velezf/lora-rocket-telemetry/RocketLoRaTelemetry/Feather9x_RX/README.md

# Feather9x RX — Ground Station Firmware

Receiver firmware for the Adafruit Feather M0 + RFM95 LoRa ground station.
Parses incoming telemetry packets, pretty-prints to USB serial, and
sends ACK replies to the rocket.

See the [parent README](../README.md) for full system documentation.
