velezf/lora-rocket-telemetry/docs/site/images/card-lora-radiorocket-v2.jpg

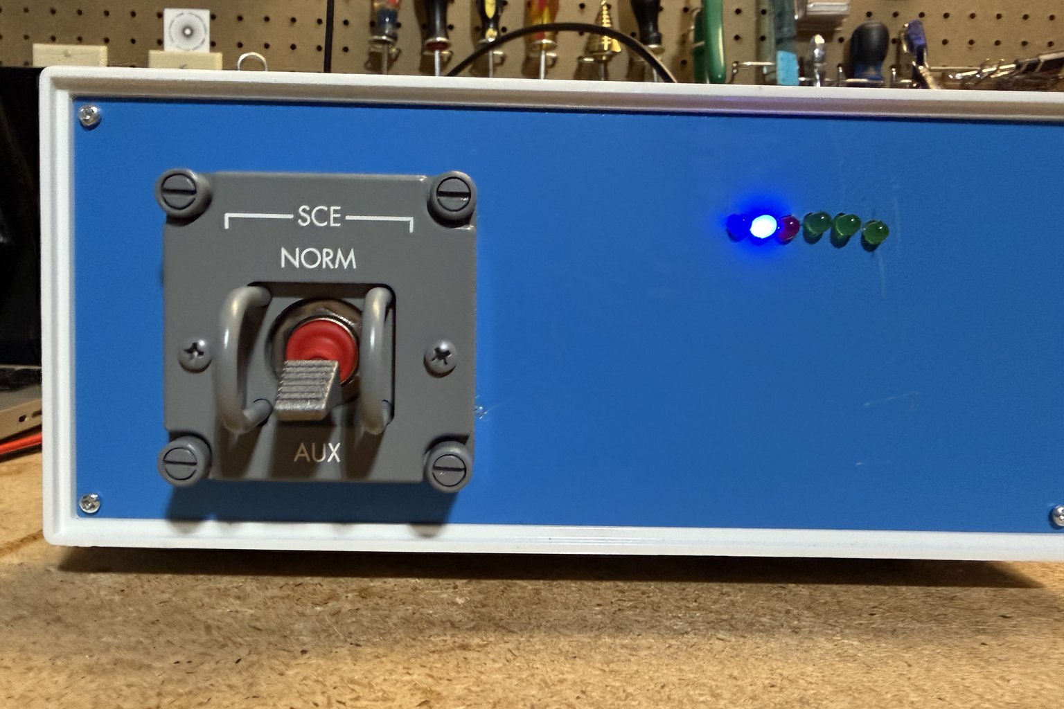
docs/site/images/card-lora-radiorocket-v2.jpg
