velezf/lora-rocket-telemetry/docs/site/images/v2-gs-interior-2.jpg

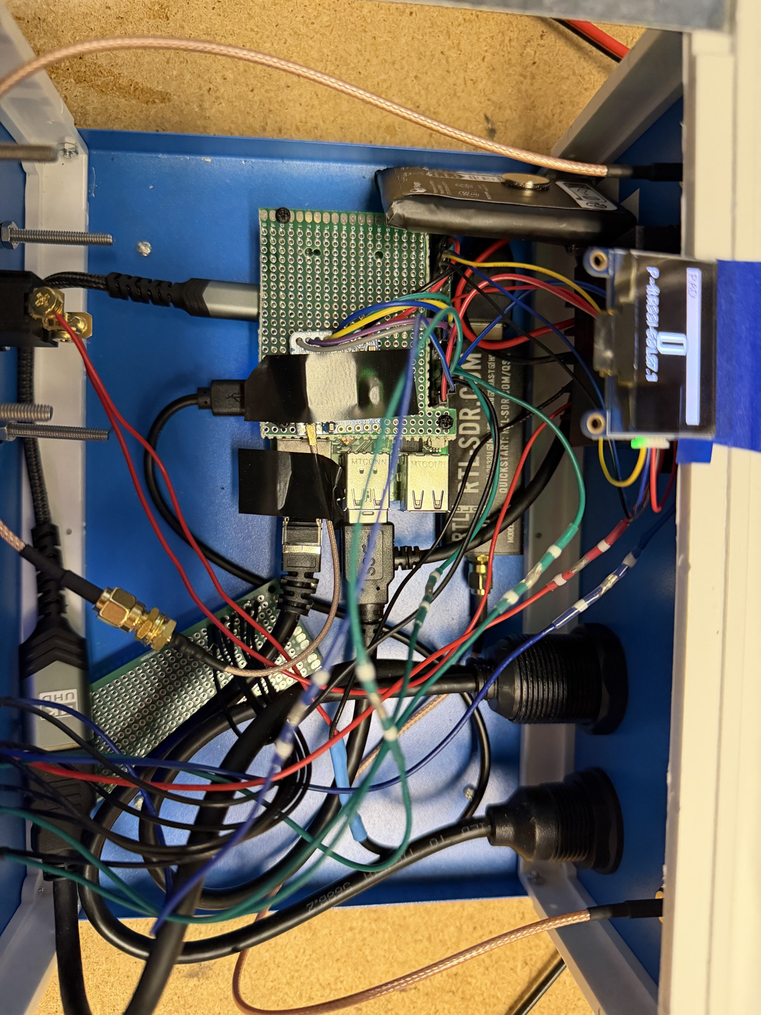
docs/site/images/v2-gs-interior-2.jpg
