velezf/lora-rocket-telemetry/RocketLoRaTelemetry/Feather9x_RX/Rx_BaseStation/Basestation1.jpeg

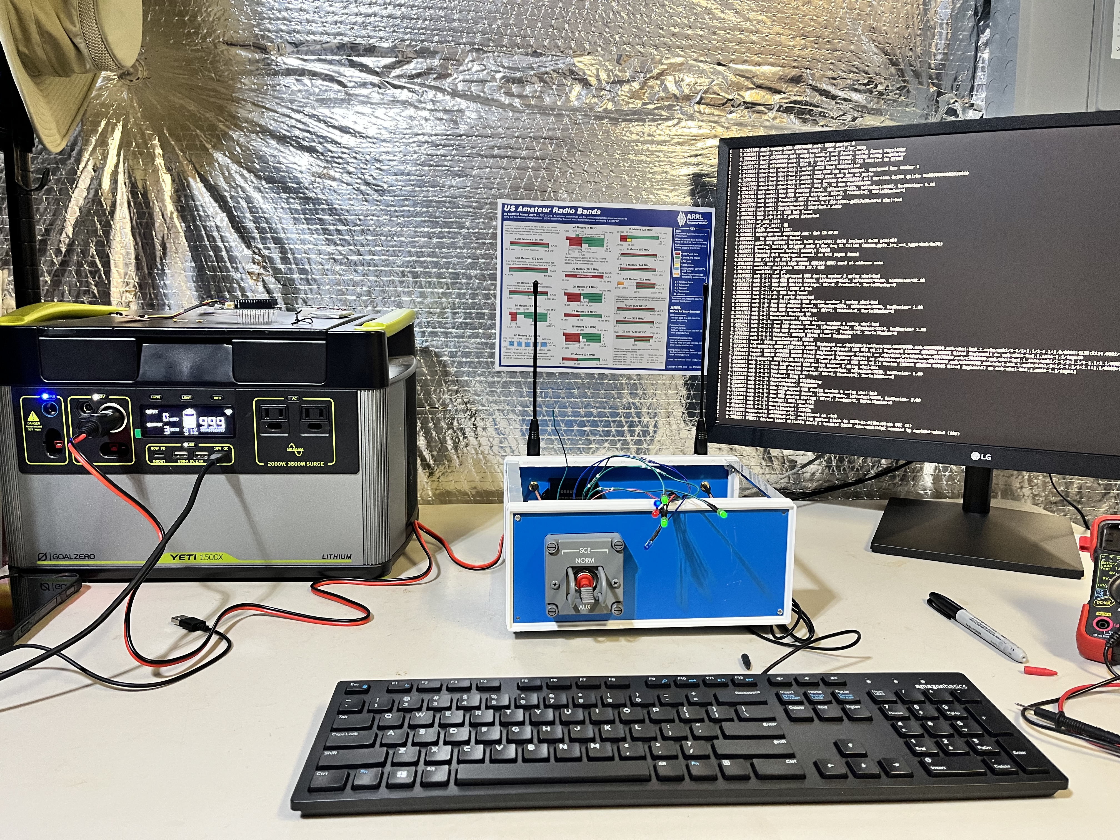
RocketLoRaTelemetry/Feather9x_RX/Rx_BaseStation/Basestation1.jpeg
