velezf/lora-rocket-telemetry/RocketLoRaTelemetry/Feather9x_RX/Rx_BaseStation/Basestationfront.jpeg

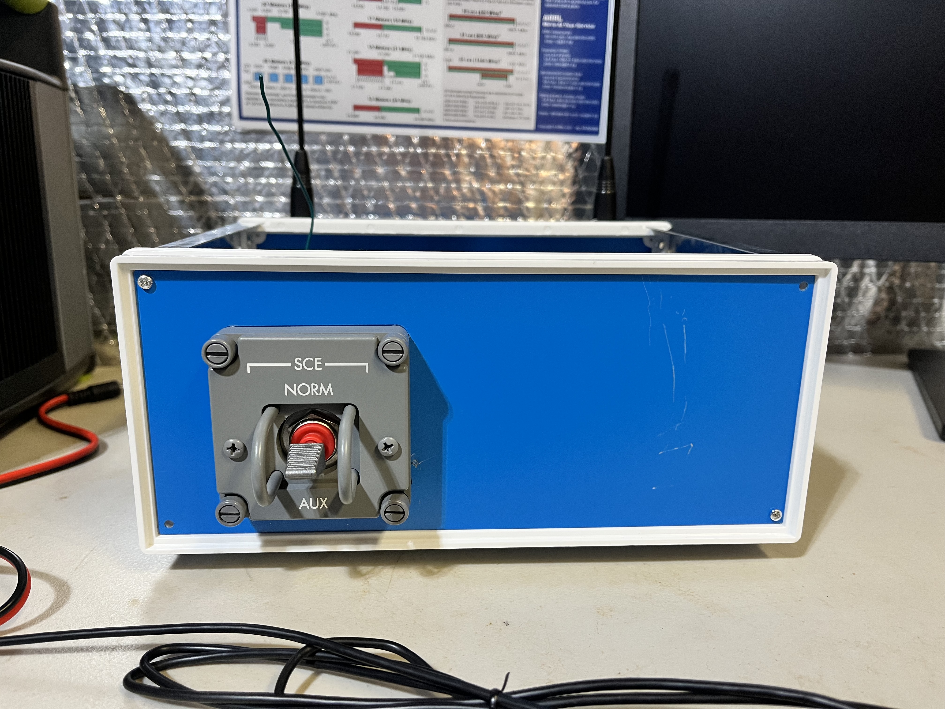
RocketLoRaTelemetry/Feather9x_RX/Rx_BaseStation/Basestationfront.jpeg
