velezf/lora-rocket-telemetry/RocketLoRaTelemetry/Feather9x_RX/Rx_BaseStation/RangeSetup.jpeg

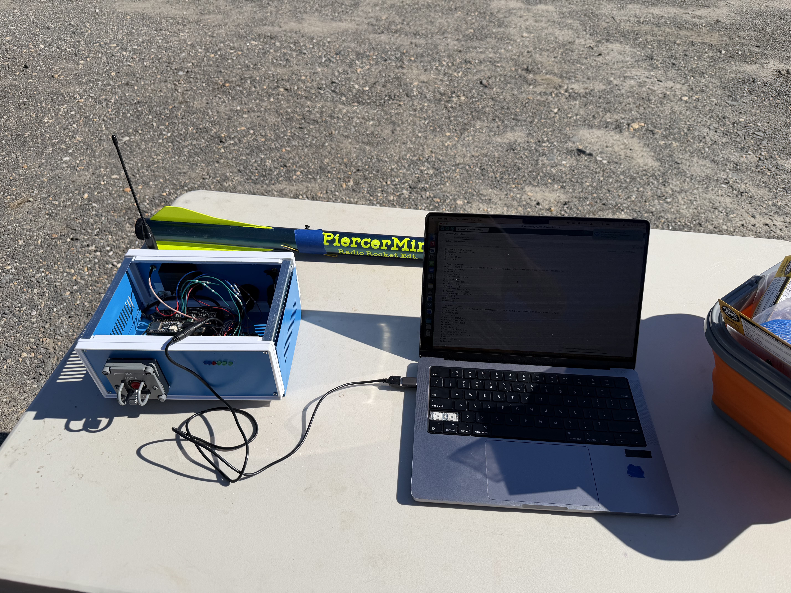
RocketLoRaTelemetry/Feather9x_RX/Rx_BaseStation/RangeSetup.jpeg
