velezf/lora-rocket-telemetry/handheld/app/game.py

"""Guess-the-apogee (Epic 8.4) — pure game logic, time injected.

KID-TWEAKABLE KNOBS (Epic 8.5 — change these, restart the service):
    PLAYERS      who gets a guess, in dialing order (names show on the OLED —
                 keep them ~7 chars so they fit the 128 px screen)
    RULE         "closest" = smallest |guess - actual| wins (over or under);
                 "no-over" = Price-Is-Right: closest WITHOUT going over —
                 everyone busts, nobody wins (the rocket wins)
    STEP_FT      how many feet one button press adds/removes
    START_FT     where the dial starts
    DEBOUNCE_S   ignore button bounces closer together than this

Phases: "rules" (startup: pick the game — dial toggles Closest/NoOver,
lock confirms; the RULE knob is the preselection) -> "entry" (on the pad, dialing) -> "watching" (flight; betting window
closed at liftoff or when every seat is taken) -> "reveal" (apogee: the
actual peak and whose guess came closest — ties go to the earlier kid).
Locking is a TWO-press affair: #12 shows "<name> <guess> OK?" and only a
second #12 banks it — dialing during the OK? cancels back to adjusting.
(Field feedback 2026-08-31: one-press lock was guaranteed kid-fumble.)
A dialed-but-never-locked guess banks automatically at liftoff: a kid who
dialed 350 and got distracted by the countdown still played.
"""
from __future__ import annotations

from handheld.app.rockets import MOTORS, ROCKETS
from handheld.app.rocketsim import apogee_ft

PLAYERS = ("Bacon", "HnyBsct", "Dragon")
RULE = "closest"
STEP_FT = 25
START_FT = 300
DEBOUNCE_S = 0.15


class GuessGame:
    def __init__(self, step_ft: int = STEP_FT, start_ft: int = START_FT,
                 players: tuple[str, ...] = PLAYERS, rule: str = RULE,
                 debounce_s: float = DEBOUNCE_S):
        assert rule in ("closest", "no-over"), rule
        self.rule = rule
        self._step = step_ft
        self.players = tuple(players)
        self._debounce_s = debounce_s
        self._last_press: float | None = None

        # rules | rocket | motor | entry | watching | reveal
        self.phase = "rules"
        self.mode = "live"                   # live (radio) | lab (offline sim)
        self._menu_i = 0 if rule == "closest" else 1
        self._rocket_i = 0
        self._motor_i = 0
        self.current_guess = start_ft
        self.guesses: list[int] = []         # locked, in PLAYERS order
        self.winner: tuple[str, int] | None = None   # (player name, guess)
        self.peak_ft: int | None = None
        self.confirming = False
        self._dial_touched = False
        self._seen_flight = False
        self._stashed: list[int] | None = None   # real-flight guesses parked
                                                 # during an armed side quest

    @property
    def entering_name(self) -> str:
        return self.players[len(self.guesses)]

    _MENU = (("closest", "Closest"), ("no-over", "NoOver"), ("lab", "RocketLab"))

    @property
    def menu_label(self) -> str:
        return self._MENU[self._menu_i][1]

    @property
    def rocket_row(self):
        return ROCKETS[self._rocket_i]

    @property
    def motor_row(self):
        return MOTORS[self._motor_i]

    @property
    def armed(self) -> bool:
        """All guesses banked, rocket still on the pad — awaiting launch."""
        return self.phase == "watching" and not self._seen_flight

    def reset(self) -> None:
        """Start over (the #5+#6 chord, or the sled's next-flight St cycle).

        From a side quest (real guesses stashed) the chord means "leave the
        quiz", so it RESTORES the armed game rather than wiping the kids'
        real-flight guesses; a second chord from plain armed is the full
        start-over as always."""
        stash = self._stashed
        self.__init__(step_ft=self._step, players=self.players,
                      rule=self.rule, debounce_s=self._debounce_s)
        if stash is not None:
            self.guesses = list(stash)
            self.phase = "watching"          # armed again, awaiting launch

    # -- buttons ------------------------------------------------------------
    def _debounced(self, mono: float) -> bool:
        if self._last_press is not None and mono - self._last_press < self._debounce_s:
            return True
        self._last_press = mono
        return False

    def _dial_menu(self, step: int) -> None:
        if self.phase == "rules":
            self._menu_i = (self._menu_i + step) % len(self._MENU)
            key = self._MENU[self._menu_i][0]
            if key != "lab":
                self.rule = key              # live picks double as the rule
        elif self.phase == "rocket":
            self._rocket_i = (self._rocket_i + step) % len(ROCKETS)
        elif self.phase == "motor":
            self._motor_i = (self._motor_i + step) % len(MOTORS)

    def press_up(self, mono: float) -> None:
        if self.phase not in ("rules", "rocket", "motor", "entry") or self._debounced(mono):
            return
        if self.phase != "entry":
            self._dial_menu(+1)
            return
        self.confirming = False              # dialing cancels the OK?
        self.current_guess += self._step
        self._dial_touched = True

    def press_down(self, mono: float) -> None:
        if self.phase not in ("rules", "rocket", "motor", "entry") or self._debounced(mono):
            return
        if self.phase != "entry":
            self._dial_menu(-1)
            return
        self.confirming = False              # dialing cancels the OK?
        self.current_guess = max(0, self.current_guess - self._step)
        self._dial_touched = True

    def press_lock(self, mono: float) -> None:
        if (self.phase not in ("rules", "rocket", "motor", "entry",
                               "watching", "reveal")
                or self._debounced(mono)):
            return
        if self.phase == "watching":
            if self.armed and self.mode == "live":
                # side quest: play RocketLab while awaiting launch — the
                # real-flight guesses are STASHED, never lost
                self._stashed = list(self.guesses)
                self.guesses = []
                self.confirming = False
                self.mode = "lab"
                self.phase = "rocket"
            return
        if self.phase == "reveal":
            if self.mode == "lab":           # another round while waiting
                self.guesses = []
                self.winner = None
                self.peak_ft = None
                self.confirming = False
                self.phase = "rocket"
            return
        if self.phase == "rules":            # game confirmed
            if self._MENU[self._menu_i][0] == "lab":
                self.mode = "lab"
                self.phase = "rocket"
            else:
                self.phase = "entry"
            return
        if self.phase == "rocket":
            self.phase = "motor"
            return
        if self.phase == "motor":
            self.phase = "entry"
            return
        if not self.confirming:              # first press only ASKS
            self.confirming = True
            return
        self.confirming = False              # second press BANKS
        self.guesses.append(self.current_guess)
        self._dial_touched = False
        if len(self.guesses) >= len(self.players):
            if self.mode == "lab":
                self._lab_reveal()           # the sim answers NOW: no launch
            else:
                self.phase = "watching"

    def _lab_reveal(self) -> None:
        peak = apogee_ft(self.rocket_row, self.motor_row)
        self.peak_ft = peak
        if self.guesses:
            i = min(range(len(self.guesses)),
                    key=lambda i: abs(self.guesses[i] - peak))
            self.winner = (self.players[i], self.guesses[i])
        self.phase = "reveal"

    # -- flight-driven transitions ------------------------------------------
    def on_view(self, view) -> None:
        if view.st is not None and view.st != 0:
            self._seen_flight = True
            if self.mode == "lab":
                # A REAL LIFTOFF PREEMPTS THE QUIZ (decided 2026-08-31):
                # the lab round is discarded, the flight owns the screen —
                # and stashed real-flight guesses come back for the reveal
                self.mode = "live"
                self.phase = "watching"
                self.guesses = (list(self._stashed)
                                if self._stashed is not None else [])
                self._stashed = None
                self.confirming = False
        # St RETURNED to 0 after a flight = next launch: fresh round. The
        # transition matters: plain pad frames must NOT reset a locked-in
        # game awaiting launch (family bench 2026-08-31 — it bounced kids
        # back to the menu the moment they finished locking in).
        if (self.phase in ("watching", "reveal") and view.st == 0
                and self._seen_flight):
            self.reset()
            return
        if self.phase == "rules" and view.st is not None and view.st != 0:
            self.phase = "watching"          # it flew mid-menu: no game this round
        if self.phase == "entry" and view.st is not None and view.st != 0:
            if self._dial_touched and len(self.guesses) < len(self.players):
                self.guesses.append(self.current_guess)   # a dialed kid still played
                self._dial_touched = False
            self.confirming = False
            self.phase = "watching"
        if (self.phase in ("entry", "watching") and view.apogee_reveal
                and view.peak_ft is not None):
            self.peak_ft = view.peak_ft
            peak = view.peak_ft
            eligible = range(len(self.guesses))
            if self.rule == "no-over":
                eligible = [i for i in eligible if self.guesses[i] <= peak]
            if self.guesses and eligible:
                # min() is stable: equal distances resolve to the earlier kid
                i = min(eligible, key=lambda i: abs(self.guesses[i] - peak))
                self.winner = (self.players[i], self.guesses[i])
            self.phase = "reveal"
