velezf/lora-rocket-telemetry/(commit log)

2026-05-09 cleanup: remove vendored libraries (all available via Arduino Library Manager)
2026-05-09 Add files via upload
    photos: add RX ground station build photos
2026-05-09 cleanup: remove N3VEM ground station photos zip
2026-05-09 docs: rewrite GroundStation README for LePotato APRS digipeater build
    Condensed the readme to focus on key project details and removed outdated sections.
2026-05-09 Correct 'mid-power' to 'High-power' in readme
2026-05-09 docs: update root README with real-time framing, NAR L1, and Zephyr high-power status
    Updated project description and telemetry details for clarity.
2026-06-29 feat(firmware): scaffold PlatformIO dev environment for sled
    Greenfield firmware/ PlatformIO project for the Feather M0 sled (the
    only C++ node). Two build environments:
    - feather_m0_tx: atmelsam / adafruit_feather_m0 / arduino, pinned
    lib_deps: RadioHead 1.120.0, Adafruit BMP3XX 2.1.6, ADXL375 1.1.2,
    Unified Sensor 1.1.15
    - native: dependency-free host env for Unity logic tests
    lib/README records the purity rule (no Arduino.h / no RadioHead in lib/)
    that keeps logic native-testable. Build artifacts (.pio/, machine-specific
    .vscode files) gitignored. Existing V1 RocketLoRaTelemetry/ firmware
    untouched (reference only).
    Epic 1, tasks 1.1 and 1.2.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
2026-06-29 test(firmware): add native test harness with RED->GREEN smoke test
    Proves the host-side Unity loop runs on macOS with no board attached: a
    deliberately failing assertion was confirmed to fail and propagate a non-zero
    result (RED), then corrected to pass (GREEN).
    test_ignore = * on the feather_m0_tx env guarantees host-logic tests are never
    cross-compiled to the SAMD target; run the suite with `pio test -e native`.
    A bare `pio test` is a safe no-op since default_envs is pinned to the board
    for build/upload.
    Temporary canary — superseded by the first real logic unit when the V1 .ino
    logic is ported.
    Epic 1, task 1.3.
2026-06-29 handheld(epic8): platform groundwork — ADR + provisioning runbook + uv env
    Capture the Pi Zero 2 W "kids' mission-control handheld" (Epic 8) platform
    decision and reproducible bring-up while the Pi was on the bench. Receiver-only
    node on the shared v1 packet contract; reuses the Epic 2.5 native-RX pattern.
    - ADR 0001: Pi Zero 2 W + Adafruit LoRa Radio Bonnet (RFM96W, 434 MHz) + PiSugar 3,
    Python/Blinka via uv, rpi-lgpio shim for kernel-6.x GPIO.
    - README: verified fresh-card provisioning runbook (apt, I2C/SPI, PiSugar,
    uv env, swig/liblgpio-dev build deps) + the Trixie zram-tools gotcha.
    - uv env: pyproject + uv.lock + .python-version mirroring ~/radio on the device.
    Groundwork only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
2026-06-30 docs(adr): packet format v1 — shared telemetry contract
    Locks the v1 wire contract between the sled TX and every receiver:
    space-delimited keyed KEY:VALUE ASCII with a leading V:1 version field.
    Defines the field spec, a golden example packet, and the versioning
    policy (reject unknown versions; additive tags within a version; only
    breaking changes to existing tags bump V). The C encoder (3.2) and the
    Python decoder (4.1) both assert against this ADR's golden vector.
2026-06-30 docs(adr): align handheld ADR packet example with locked v1 contract
    The handheld ADR's inline example predated the lock and showed the legacy
    `t+12s` time token (and St in a different slot). Replace it with the
    authoritative golden vector (MET:12) from docs/adr/0001-packet-format-v1.md
    and link to that ADR as the single source of truth, so the 8.2 parser is
    written against the real contract.
2026-06-30 docs: add CLAUDE.md project memory + docs/RESUME.md status
    CLAUDE.md captures the durable working agreement (branch-per-feature,
    Frank reviews/approves every commit & merge, TDD, commit conventions, the
    lib/ purity rule, pio invocation, hardware gating) and points at the
    keystone packet ADR. docs/RESUME.md is the living status/handoff doc —
    current epic, open branches, locked decisions, next steps — to read first
    when resuming, especially across the Mac/Pi 5 split.
2026-06-30 docs: record Epic 2 ground-station progress; Bookworm -> Trixie
    Ground station apogee-gs is on the network: 2.1 OS baseline (updates, EEPROM
    flashed, headless SSH, I2C+SPI enabled), 2.2 Wi-Fi-on-boot (home WideRoad
    first, iPhone hotspot fallback, cold-boot rejoin verified), and Pi Connect
    (rpi-connect-lite, signed in as apogee-gs). 2.3/2.4 deferred; 2.5/2.6
    hardware-blocked; hotspot fallback not yet field-verified.
    Also corrects the plan's 2.1 OS from Bookworm to Trixie (Debian 13), the
    image actually flashed. Hotspot credentials are NOT stored in the repo.
2026-06-30 docs(resume): Epic 2 software side complete (2.3/2.4 + auth + Python 3)
    Ground station apogee-gs is software-complete: Claude Code installed and
    authenticated (claude.ai Max), GitHub read-only deploy key + clone + pull
    verified, Python 3.13.5 confirmed (venv works; no system pip, uv not yet
    installed). Epic 2 row flips to green — only 2.5 radio / 2.6 PiSugar remain
    (hardware-blocked). Next steps: optional uv install, then Epic 3 firmware.
2026-07-07 docs(ground-station): add wiring reference + LED bring-up tool
    Capture the locked apogee-gs pin map (RFM96 radio on SPI0/CE1, OLED on
    I2C1 @0x3D, six active-high front-panel LEDs) in docs/ground-station-wiring.md,
    bench-verified 2026-07-07. Add ground/tools/led_check.py: a gpiozero (lgpio
    backend, Pi 5 safe) sweep+chase to bring up / troubleshoot the panel LEDs.
    The LED harness was cross-wired (LED3-LED6); the doc and the tool's default
    pin list record the corrected physical order 5,6,13,26,12,16 (green x3, red,
    blue x2 left->right).
    [led_check.py]
2026-07-07 docs(resume): Epic 2.5/2.6 hardware wired & bench-verified
    Radio (SPI0/CE1, RegVersion 0x12), OLED (I2C1 0x3D) and PiSugar (0x57 batt
    + 0x68 RTC) wired and verified on the bench; live RX confirmed from the V1
    sled. Record the wired-peripherals table and point next steps at the 2.5
    radio-RX software env.
2026-07-07 feat(firmware): port V1 reference TX to PlatformIO src/
    Faithful PlatformIO port of RocketLoRaTelemetry/Feather9x_TX/
    Feather9x_TX_V1.2.6.ino so the sled builds and flashes from this repo. Serves
    as the Epic 1.4 upload-smoke follow-through: restores the sled as a working
    434 MHz transmitter after the smoke sketch. Still emits the legacy V1 payload
    (ALT:/Max:/Batt:), NOT the ADR-0001 contract — the ADR-format encoder is the
    real Epic 3 work.
    Deviations from the .ino:
    - bounded 2s wait for Serial instead of blocking `while(!Serial)` (runs headless)
    - ASCII status tags (IDLE/ASC/DESC) instead of emoji
    Verified: builds for feather_m0_tx, uploads via SAM-BA, transmits; received on
    the apogee-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
2026-07-07 feat(firmware): apogee detection as host-tested pure unit (Epic 3.6)
    Extract the V1 apogee-detection logic (Feather9x_TX_V1.2.6.ino) into a
    pure, portable apogee::Detector: tracks running max altitude, fires once
    when altitude first drops below the peak, and latches descending. No
    <Arduino.h>/RadioHead, so it builds and runs in the native env.
2026-07-07 feat(firmware): packet encoder for ADR-0001 v1 format (Epic 3.2)
    Pure, portable C++ encoder for the keystone v1 telemetry contract. Emits
    the space-delimited KEY:VALUE ASCII packet with leading V:1 in canonical
    field order, with fixed unit suffixes (ft/C/V) and per-field precision
    (G/Pg/T one decimal, Batt two decimals). Builds and runs in the native
    host env (no Arduino.h, no RadioHead). Unity tests assert the ADR golden
    vector byte-for-byte plus a second fixture guarding negatives, SEQ wrap,
    and rounding.
    [test_packet.cpp]
2026-07-07 feat(ground): SX127x LoRa RX driver + ADR 0002 (Blinka rejected)
    Importable SX127x LoRa RX driver (ground/rx/sx127x.py) with an injected SPI
    transport, so register/frame logic is host-tested against a fake SPI (11 tests).
    Enforces CRC (drops + counts bad frames), validates the RadioHead 4-byte header
    (nb>=5) and exposes TO/FROM/ID/FLAGS, config object for freq/SF/BW/CR/sync.
    Hardware transport (spidev + lgpio) isolated behind lazy imports. ADR 0002
    records the decision to use raw spidev + lgpio and reject Blinka (RPi.GPIO won't
    run on BCM2712; nothing else uses Blinka).
    [sx127x.py, test_sx127x.py, transport.py]
2026-07-07 chore: ignore and untrack Python bytecode (__pycache__/*.pyc)
    Add a root .gitignore and untrack the .pyc files accidentally committed with
    the ground RX driver. Files stay on disk; only the tracking is removed.
2026-07-07 feat(firmware): emit ADR v1 packets — integrate encoder/launch/apogee/convert
    Rewire the sled TX loop to build packets from the merged, host-tested pure
    units (lib/packet, lib/launch, lib/apogee, lib/convert) and emit the ADR-0001
    v1 format, replacing the legacy V1.2.6 string. Live-state wiring folds in
    Epic 3.3/3.4: SYS default 7, SRC 1=sled, SEQ per-TX counter (wraps 65535),
    St flight-state (0 pad / 1 ascent / 2 descent), MET seconds since launch. All
    formatting lives in the encoder — no format strings in src/.
    platformio.ini: -Wl,-u,_printf_float — newlib-nano drops %f from printf by
    default, so float tags (G/Pg/T/Batt) encoded empty on-target while host tests
    passed. Caught by the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
2026-07-07 docs(resume): refresh — Epic 3 complete, ground RX driver, hardware state
    Bring RESUME up to date: Epic 1 done (1.4 proven), Epic 2 done (2.5 RX driver
    + 2.6 shutdown; only 2.2 hotspot field test left), Epic 3 complete (sled emits
    ADR v1, e2e verified 22/22, B4/B5 folded in), Epic 5.1 evidence done. Record
    ADR 0002 (ground RX = raw spidev+lgpio, Blinka rejected), the bench hardware
    state, the e2e standing-gate + newlib-nano float-printf + Feather double-tap
    learnings, and the Pi scratch debris to clean up in 4.2. Next: Epic 4.
2026-07-07 docs: add HANDOFF.md — catch-up prompt for a fresh Claude session
    A copy-paste prompt that summarizes current project state (Epics 1/2/3 done,
    ADR 0001/0002, standing e2e gate, gotchas, Epic 4 next) so a new Claude session
    doesn't re-plan finished work. Points at RESUME.md as the live status.
2026-07-07 feat(ground): ADR v1 packet decoder (Epic 4.1)
    Pure decode(bytes) -> DecodedPacket | DecodeError for the ADR-0001 v1 wire
    format. No radio/I-O imports — host-testable, green on Mac and Pi. Structured
    errors, never raises: empty / not-ascii / no-version / unsupported-version /
    malformed-token / bad-value. Enforces the additive-extension policy (unknown
    tags tolerated + surfaced raw; missing tags valid) and strips ft/C/V suffixes.
    16 tests: golden vector, unknown/missing-tag, malformed/truncated/empty/
    double-colon/bad-value/non-ascii, wrong-version, never-raises junk sweep.
    Live e2e verified: sled TX -> RX driver -> decoder, 13/13 decoded_ok.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
2026-07-07 feat(ingest): append-only session-log record builders
    Epic 4.2: pure/deterministic builders for the ground ingest service's
    JSON Lines session log. packet_record lifts sys/src/seq and preserves
    decoded fields, unknown tags, and the verbatim raw payload (re-decodable
    history); event_record emits advisory events; to_jsonl serializes compact
    JSONL. Caller supplies timestamps — no clock/I/O here.
2026-07-07 feat(ground): add per-(SYS,SRC) link stats tracker (Epic 4.3)
    Pure-Python, stdlib-only LinkStats class tracking packet-loss and RSSI
    link quality per (sys, src) transmitter key (design decision D3) — never
    a global last_seq, so a gap in one source never affects another. SEQ
    missed-packet inference is uint16-wraparound aware (mod 65536, ADR 0001).
    TDD: failing tests first, then implementation. 13 host tests cover
    per-source independence, SEQ wraparound, and RSSI min/max/mean.
2026-07-07 feat(ground): ingest service — radio owner + JSONL log + foreign-traffic policy (Epic 4.2)
    Single radio-owning process (D4): SX127xRx -> decode -> IngestCore -> queue-backed
    JSONL writer (D1, radio loop never blocks on disk) + per-(SYS,SRC) LinkStats +
    ObserverRegistry fan-out. Per-start session files, advisory service_start/stop +
    foreign_sys/unknown_src event records, clean SIGTERM shutdown. systemd unit.
    Foreign-traffic policy (addendum A): only configured SYS (default {7}) + known SRC
    (default {1,2}) feed stats/dispatch; foreign-SYS and unknown-SRC valid packets are
    counted + logged as advisory events with raw preserved, never into stats/flights.
    SYS allowlist / known-SRC are field co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
2026-07-07 feat(ground): Part-97 callsign ID handling — decoder fixture + ingest audit trail
    CALL:<callsign> rides ADR 0001's additive/unknown-tag path (decoder fixture
    confirms it surfaces in .unknown). Ingest, on a CALL-bearing packet:
    - emits an advisory `id` event (callsign, SYS, SRC, timestamp) — the compliance
    audit trail;
    - verifies the CALL<->SYS binding against field config; mismatch flags an
    `id_mismatch` anomaly;
    - records callsigns seen on foreign-SYS traffic in the foreign-traffic counter.
    callsign_binding is field config (service loads it; JSON string keys -> int SYS).
    Ground-only; the sled emits CALL once the Epic 6 firmware rider lands (then the
    live CALL audit trail re-runs th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
2026-07-08 feat(ground): flight logging — segmentation, export, CLI, live detection (Epic 4.3)
    Flights are derived metadata over the raw log; three files, one writer each:
    session log (service), ops journal (CLI), flights index (derivation). Index =
    f(session, ops), so manual annotations + open/close survive re-derivation and a
    rule change (D2). Precedence: a manual close/open beats the silence timeout.
    - segmenter.py concurrent multi-bird segmentation (open on St->ascent, silence
    or manual close, force_open, silence-protect); pure/injected time.
    - derive.py canonical index from session log + ops journal, with precedence.
    - export.py pandas-friendly per-flight rows (one per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
2026-07-08 docs(resume): refresh — Epic 4 (4.1-4.3) merged; ground-service architecture
    Record Epic 4 progress: 4.1 decoder, 4.2 ingest service (apogee-ingest, enabled +
    reboot-surviving), 4.3 flight logging (journal-based, multi-bird). Add the ground
    -service design decisions (three files/one writer, index = f(session, ops), manual
    beats silence, injected time, foreign-traffic policy, Flask+Chart.js / Quarto+Plotly),
    the Epic 6 firmware riders (SRC build config, TX jitter, Part-97 CALL beaconing),
    and next steps (4.4 dashboard, 4.6 OLED, 4.5 publish).
2026-07-08 feat(ground): field-time hardening — RTC, systemd clock gate, monotonic deltas
    Boot/field clock robustness after the stale-clock session-name incident:
    - ingest dispatches Observation(received_at, rssi, packet, MONO); silence + flight
    duration use time.monotonic() deltas (immune to NTP/RTC wall-clock steps), while
    received_at (wall) stays what's recorded. Test: 1h wall leap -> no spurious close.
    - apogee-ingest.service orders after pisugar-server + time-sync.target (Wants, so the
    offline field never blocks) and waits (ExecStartPre) for a sane year before opening
    a session.
    - docs: PiSugar 3 RTC setup (rtc_pi2rtc + auto_rtc_sync); handheld replicates it.
    PiSugar RTC initialized + a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
2026-07-08 chore(ground): loose-ends sweep — collision-proof sessions, clean diagnostics
    1. Collision-proof session filenames: session_filename() appends a random suffix
    so two starts in the same second can never append two runs into one file
    (uniqueness by construction, not by clock correctness). 2 tests.
    2. Diagnostics: add pyrightconfig.json so ground.* imports resolve; fix a real
    set/frozenset nit in derive.py; dismiss the Pi-only imports (spidev/lgpio/
    gpiozero) and test-file union-access (pyright doesn't narrow assertIsInstance)
    with inline/per-file reasons. `pyright ground/` is now 0 errors.
    3. RESUME: field-time hardening, Epic 6 riders (now five), physical-tasks
    checklist,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
    [led_check.py, test_sx127x.py]
2026-07-08 feat(ground): live dashboard — Flask + Chart.js, in-process consumer (Epic 4.4)
    In-process (D4 decision): one radio owner; the dashboard is a daemon thread reading
    only immutable snapshots — never SPI, the session log, or the index. Boring stack:
    built-in threaded server on 0.0.0.0:8080, polling, no WSGI/auth/DB.
    - dashboard/model.py LiveState (each update builds a NEW immutable snapshot and swaps
    the reference — atomic under the GIL, no locks/torn reads; bounded
    trace tuple) + view_model. Pure, host-tested.
    - dashboard/app.py thin Flask shell (lazy import; degrades silently if absent).
    - templates/index.html phone-sized per-SRC panels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
2026-07-08 feat(dashboard): AGL pad baseline + density view-model on immutable snapshots
    Per-SRC pad baseline (rolling mean of ALT while St:0); dashboard shows
    ALT-baseline as AGL, PEAK computed on AGL, raw ALT untouched in records;
    baseline resets on flight_close. LiveState keeps immutable snapshots
    (update REPLACEs the reference, never mutates) with a bounded trace that
    carries RSSI alongside altitude. Adds EventsRing (bounded, newest-first)
    and density fields (received_at, met_s, operator callsign) to view_model.
2026-07-08 feat(oled): SSD1306 status display — host-tested render + Pi luma shell
    Pure oled_lines(panel) -> 4 lines (SRC/callsign, ALT/PEAK AGL, state/flight,
    RSSI/loss) host-tested in native; OledDisplay is the Pi-only luma.oled shell
    (I2C 0x3d) with lazy imports that swallows all I/O errors so a missing or
    failing panel degrades silently and never touches the radio owner.
    [render.py, test_render.py]
2026-07-08 feat(ingest): wire OLED + density + baseline-reset; run service from gs-venv
    Registers the OLED consumer and tees the log sink into EventsRing; view_model
    health now carries packets_per_min/foreign/anomalies; live.tick() returns closed
    flights so the loop resets each SRC's AGL baseline on flight_close. ExecStart now
    points at gs-venv python — the one env with luma+flask+spidev+lgpio — since system
    python no longer has luma for the OLED.
2026-07-08 test(flights): real-RF golden fixture from first flight 2026-07-08-F1
    Version-controls the F1 shake-test session slice (75 real over-the-air packets +
    flight_open/close events) and the ops-journal annotation. test_f1_golden asserts
    the full contract chain — decode(raw bytes) -> segment -> derive — reproduces F1's
    index entry exactly (dur 87.556s, 75 rx, 1 lost, peak -74ft, rssi -38..-14, label
    "shake test"), and that re-derivation is byte-identical. Real bytes now guard the
    decoder + segmenter + derivation against silent regressions, like the ADR golden
    vector does for the wire format.
2026-07-08 docs(resume): first flight F1 logged; launch detect samples at 1 Hz
    Records 2026-07-08-F1 (full pad->ascent->descent->close cycle proven live: badge/
    T+/AGL, OLED ascent, baseline reset; derivation round-trip byte-identical) + the
    golden fixture. Firmware finding: launch detection reads the ADXL once per TX loop
    (1 Hz, no FIFO/ISR) — hand-jerks miss, a sustained circular swing trips it. Adds
    Epic 6 rider #6 (St-dependent TX rate; do the duty-cycle/airtime math first, and
    note detection sampling is TX-coupled today). Physical checklist down to overnight
    boot + hotspot field test.
2026-07-09 feat(flights): stability-gated pad baseline v2 (pure unit)
    pad_baseline(): a trailing low-variance window of pre-boost pad ALT, dropping the
    final pre-boost samples and locking the mean IFF stdev <= 2.0 ft (else None -> raw
    fallback). Replaces the naive 'rolling mean of every St:0 ALT', which averaged in
    stale early drift + the boot-settling transient. Window (15 samples) mirrors V1's
    short pre-use average adapted to the ~1 Hz ground rate; the variance gate is derived
    from real F1 pad noise (V1 had none). Audit doc records the V1 algorithm (boot-mean +
    BMP IIR; 'trimmed-mean' header unimplemented) and why the firmware boot-settling bias
    is a cosmetic note, not a rider (it cancels in AGL).
    C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
    [test_baseline.py]
2026-07-09 test(flights): widen F1 golden with pre-boost pad; assert baseline -84
    Prepends the 19 real quiet pre-boost pad packets (SEQ 0-18, ALT -83..-85) to the F1
    fixture so the golden recomputes a real AGL zero: baseline_ft -84 over n 15, peak AGL
    -74 - (-84) = 10 ft (sensor noise; a swing, not a climb). Golden now asserts the
    baseline exactly alongside the rest of F1's index entry.
2026-07-09 docs(resume): AGL baseline v2 merged; F1 baseline -84; 4.5 plan w/ review notes
    Records baseline v2 (pure pad_baseline shared by live+derive; locks at flight_open,
    stored per flight in the index), F1 recomputed (baseline -84, peak 10 ft AGL noise),
    the audit doc, and the signed-off 4.5 model + additions (--field ASL, peak-AGL-led
    landing table, per-page baseline audit, F1 as genesis entry). Suite 129 tests.
2026-07-09 feat(publish): data-only flight publisher (flights.json + CSV, permalink)
    Stage-1 of 4.5 web publish: flights publish ships DATA ONLY into the portfolio site
    repo (a flights.json summary + per-flight CSVs under projects/lora-flights/), never a
    .qmd. Pure host-tested generators: flights_summary (peak AGL = peak_alt_ft - baseline_ft,
    baseline_ft/baseline_n travel with each record; newest-first), permalink (OJS URL-param
    deep link …/projects/lora-flights.html?flight=<id>), write_flight_data. 8 tests.
2026-07-09 chore(env): uv Stage-1 render env + lora-rocket-telemetry kernel
    Portfolio Workflow doc Stage-1: a uv .venv (gitignored) with jupyter/pandas/numpy/
    matplotlib/seaborn, registered as the lora-rocket-telemetry jupyter kernel, which
    renders the flights writeup page (projects/lora-flights.qmd). This env is only for
    that render — the ground station + host tests run on system python3.
2026-07-09 docs(resume): end-of-night marker; pages branch awaiting merge, Stage-3 tag pending
2026-07-13 docs(resume): backlog — manual flight-open/close 'log' button (invariant-respecting design)
2026-07-14 feat(clock): RTC-boot-restore runner + fail-closed gate + field attest + systemd oneshot
    apogee-rtc-restore oneshot (After=pisugar-server, Before=apogee-ingest) reads the PiSugar
    RTC via the pisugar-server API and sets a bogus/stale system clock, dropping the trust
    marker /run/apogee-rtc-restored; audit to journald only (never session/ops/index). ingest
    ExecStartPre is now the fail-closed ground.clock.gate (NTP OR marker; plausible-year floor
    alone no longer passes). StartLimitIntervalSec=0 so the fail-closed gate retries until the
    clock is trusted without start-limit lockout. Field escape hatch (attest_clock + reset-failed)
    documented. +extract_rtc_time (pisugar reply parser). 158 tests, sy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
2026-07-27 docs(resume): close overnight cold-boot item — RTC-boot-restore verified
    Wi-Fi-OFF cold boot on 2026-07-27 (no network at boot; Ethernet unplugged until +15 min)
    PASSED: the timesyncd-floor bug reproduced (system came up ~62 min stale), apogee-rtc-restore
    read the PiSugar RTC and set the clock (action=set/reason=sys-behind-rtc, dropping the trust
    marker) BEFORE apogee-ingest, whose fail-closed gate then passed on the marker, not NTP (first
    NTP sync was 15 min later, postdating both the clock-set and the session-open) and opened a
    correctly-named session. Folds in criterion (1): the PiSugar RTC held correct time across a
    ~13-day powered-off hiatus at 69% (no drain), so the 30-min hold need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
2026-07-27 fix(clock): apogee-attest oneshot — escape hatch no longer cwd-dependent
    Bench-testing the field escape hatch surfaced that the documented `python -m
    ground.clock.attest_clock` fails with ModuleNotFoundError unless run from the repo root —
    the systemd units get WorkingDirectory= for free, but a stressed operator following the
    docstring verbatim at the pad would not. Fix removes the cwd-dependent failure class rather
    than just documenting the `cd`:
    - New apogee-attest.service oneshot (Type=oneshot, no RemainAfterExit so re-attest re-runs;
    no [Install] — operator-invoked only) carrying the same WorkingDirectory= as
    apogee-rtc-restore. Field procedure is now three consistent, cwd-ind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
2026-07-27 docs(resume): backlog — unit-install drift guard
    Three units now versioned in ground/ingest/ but executing from /etc/systemd/system/, with a
    hand-recreate step on SD rebuild — the same docs-vs-machine drift class the escape-hatch cwd
    bug was. Records the cheap fix (verify-installed-matches-repo check, or one sanctioned
    install-units.sh) to pick before Epic 8 replicates the config. Not implemented.
2026-07-27 docs(pisugar): wake-on-charge (auto_power_on) + rising-edge semantics
    Enable auto_power_on:true on the ground station (complement to the 2.6 low-battery
    auto-shutdown): reconnecting power auto-boots the box, no button press. Records the
    rising-edge semantics as the *reason*, not just the setting — auto_power_on fires on the
    transition of power being (re)connected, not on power being present. That is why
    `poweroff` with the charger plugged stays off (verified 2026-07-27: dark >100 s, no
    bounce) and why unplug->replug wakes it (verified 2026-07-27, woke on the replug edge) —
    so there is no "boots in the bag" footgun, and an unexpected wake means a power reconnect,
    not a timer. Pi-side conf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
2026-07-29 docs(clock): make ADR 0003 the one canonical escape-hatch copy
    The field escape-hatch procedure had drifted into four copies (attest_clock.py docstring,
    gate.py message, ADR 0003, wiring doc) — the wiring doc still showed the cwd-dependent
    `python -m` invocation the apogee-attest oneshot replaced. Syncing four copies only resets a
    drift clock, so apply one-writer discipline to the prose: ADR 0003 ("Operator escape hatch")
    is the single canonical copy; the docstring, the gate's UNTRUSTED message, and the wiring doc
    now POINT at it instead of restating the commands. No inline duplication to keep in sync.
    Also drops the obsolete `reset-failed` step (obviated by StartLimitIntervalSec=0).
    Co-A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
2026-07-30 docs(provenance): bench-sessions register — quarantine non-flight sessions
    Adds docs/bench-sessions.md: a canonical, append-only register of ground-station session
    logs produced by bench tests rather than flights, so a future reader (or a `flights rebuild`
    sweep) doesn't mistake them for real telemetry. Session logs are Pi-only and disposable; this
    is their durable, version-controlled provenance. One canonical list (not restated in RESUME or
    a drifting Pi-side manifest) — RESUME carries a single pointer. Seeded with the two known
    artifacts: the pre-fix mis-dated boot session-20260709T015114Z (1493 real packets but 0 flight
    events — real RF that never tripped launch detect) and the apog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
2026-07-30 docs(resume): backlog — feat/oled-reinit-recovery
    luma sends the SSD1306 init sequence only at service startup; a power-cycled OLED (connector
    reseat in transit) resets to display-OFF but still ACKs on the bus, so luma writes pixels to a
    dark panel and the OLED blanks for a whole launch, silently, with no error surfaced. Found
    2026-07-30 (a rewire mid-run blanked it; only a restart re-inited it). Records the cheap
    self-heal options (periodic re-init / re-init on I2C error / display heartbeat) with a
    recommendation of periodic re-init — the only one that covers the silent no-error blank. Same
    bug class for the Epic 8 handheld OLED. Not implemented.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
2026-07-30 docs: merge OLED riders into feat/oled-heartbeat; clarify DIO0/pin-15
    OLED diagnosis 2026-07-30 (rewire verification): the "dark" panel was NOT a hardware fault —
    raw SSD1306 white-fill + a luma text frame lit it, confirming genuine SSD1306 + good glass/
    cable/power. Root cause was firmware: renders only fire on a packet callback, so a quiet pad
    shows luma's cleared-black init state. Merges the earlier oled-reinit-recovery + oled-idle-page
    backlog notes into one feat/oled-heartbeat: a single periodic redraw loop (every 1-2s) fixes
    both the no-idle-page blank and the silent reset-blank (unconditional periodic re-init).
    Also adds an explicit DIO0/pin-15 line to the wiring doc: DIO0 is delib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
2026-07-30 feat(pisugar): graceful button off-switch (double-tap) + validation
    Headless field off-switch so shutdown closes the append-only session log cleanly. PiSugar
    config (applied on the Pi, documented here): double_tap -> /usr/bin/systemctl poweroff;
    soft_poweroff_shell = same command (one graceful definition, two triggers: human + low-batt);
    single/long taps disabled; anti_mistouch on.
    Validated 2026-07-30 — both paths close the log cleanly (a real finding: the micro-USB
    "hard" button did NOT truncate):
    - USB-C double-tap -> session ...266cc9 ended with a valid-JSON service_stop (no truncation;
    SIGTERM drain completes before pisugar-poweroff's 3s countdown — no race).
    - micro-USB button ~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
2026-07-31 docs: capture stale-hero + page persistence (oled-heartbeat); button no-force-cut line
    Two OLED design items that would vanish across a session boundary, into the feat/oled-heartbeat
    backlog at rebuild-from-cold detail:
    - Stale hero: a frozen mid-flight altitude reads identical to a live one (same lying-display
    class as the flight LED) — needs a freshness treatment (invert/blink/age) on a state-dependent
    threshold (silent PAD normal, silent ASCENT not), driven off last_rx_ts age.
    - Page selection & persistence: page chosen by flight state, not a timer; SUMMARY holds until the
    next flight opens (it's what you read walking downrange); on ingest restart mid-flight, derive
    the page fro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
2026-07-31 feat(panel): pure LED-state policy + lamp-test sweep (host-tested)
    Pure led_states(snapshot)->{led:Blink} for the six front-panel LEDs, host-tested like the
    clock logic (no hardware in the loop). RED precedence chain shutdown-pulse > low-batt-fast >
    steady-not-recording > off; greens = alive-heartbeat / RX / flight-open; blues = clock
    provenance (solid=rtc/slow=attested/off=unknown) and RF trouble (crc-climbing=fast >
    foreign=slow). Fail-closed: a stale ingest snapshot -> RED SOLID + greens OFF (correct
    degradation while ingest keeps capturing; the no-exception-escapes guarantee lives on the
    publisher). lamp_test_order() sweeps all six so a dead LED can't hide as a valid OFF. 21
    tests; OFF c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
    [leds.py, test_leds.py]
2026-07-31 feat(panel): pin G_ALIVE-never-solid invariant (self-detecting supervisor)
    G_ALIVE must blink (HEARTBEAT) or be OFF, never SOLID — so a frozen supervisor process
    (every LED stuck in its last state) is itself detectable: a stuck G_ALIVE reads as solid or
    dark, neither a blink. Adds a combinatorial property test over all state inputs asserting
    G_ALIVE is never SOLID, plus a docstring note. Pairs with Restart=always on the (future)
    apogee-panel.service.
    [leds.py, test_leds.py]
2026-07-31 feat(panel): ingest heartbeat publisher — fail-safe, temp-clean, rate-limited
    The state file ingest publishes for the LED supervisor, hardened for the failures that only
    show after hours on a pad:
    - safe_publish() NEVER raises Exception into the radio loop (returns False -> file goes
    stale -> supervisor lights RED, correct degradation while ingest keeps capturing). Uses
    `except Exception`, not BaseException, so KeyboardInterrupt/SystemExit still propagate.
    - write_state_atomic() unlinks its temp on ANY failure (write OR rename) — no slow fill of
    the small /run tmpfs at 1 Hz.
    - HeartbeatPublisher rate-limits the failure log to transitions (one line on entering
    failure, one on reco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
    [heartbeat.py, test_heartbeat.py]
2026-07-31 feat(panel): wire heartbeat into the ingest RX loop (loop-driven, 1 Hz)
    Publishes /run/apogee/ingest-state.json for the LED supervisor. Ticked from INSIDE the RX
    loop (not a timer thread) so the heartbeat proves the loop is TURNING, not merely that the
    process is up — a wedged loop stops publishing -> file stales -> supervisor lights RED. ~1 Hz
    (monotonic-gated), fail-safe publish (never escapes into the radio loop). last_rx_ts tracks
    ACCEPTED packets (core.decoded); flight_open from live.open_flight_ids(). No per-packet
    latency: the publish is loop-level (not per-packet), a sub-ms /run tmpfs write.
    RuntimeDirectory=apogee gives rocketman a writable tmpfs dir, removed on stop so a stopped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
    [heartbeat.py]
2026-07-31 docs(panel): flag RED write-failing as INERT; OLED-off-RX-thread as a requirement
    Two safety items surfaced wiring the heartbeat, captured at proper severity:
    - RED's write-failing leg is currently UNREACHABLE end-to-end: the pure core lights RED on
    write_ok=False (tested), but the ingest publisher hardcodes write_ok=True. A designed-but-
    inert safety signal is worse than an absent one. Marks it NOT-YET-WIRED wherever the RED
    chain is documented (RESUME + leds.py), and records a named backlog item (writer health ->
    write_ok) with "do not claim RED covers disk-full until wired".
    - OLED render currently runs synchronously in the RX loop, so a wedged I2C bus HALTS packet
    capture — a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
    [leds.py]
2026-07-31 feat(panel): pure supervisor logic — freshness (tz-strict), state map, blink encoding
    The judgement layer for the LED supervisor, host-tested:
    - fresh(): aware-UTC-strict staleness. None -> False (normal, silent); a NAIVE/unparseable
    ts is a tz BUG -> False AND log (else a naive-vs-aware compare TypeErrors into a permanent
    legitimate-looking RED). Future ts (clock jitter) = fresh.
    - supervisor_state(): heartbeat file (or None) + battery/clock/shutdown polls -> the
    led_states() input; raw=None -> fail-closed down snapshot.
    - is_lit(): Blink -> on/off at an 8 Hz tick. GENERATES the waveform (no sampling -> no
    aliasing); FAST=4 Hz and SLOW=1 Hz are 4x apart and must not collapse (a 1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
    [supervisor.py, test_supervisor.py]
2026-07-31 feat(panel): lamp-sweep plan — pure pacing, one tested order
    lamp_test_order() existed and was host-tested, but the Pi shell ignored it and swept
    GPIOs in numeric order — a tested function production doesn't use is a fiction, and it
    rots. lamp_sweep_plan() makes the whole sweep (order AND pacing) a pure list of
    (lit_leds, seconds) steps that the shell executes verbatim, so the properties that make
    the sweep readable by eye are pinned by test instead of living as magic sleeps in
    hardware glue no test can reach.
    Two questions, deliberately separated so the operator answers one at a time: an opening
    all-on frame answers "is any LED dead?" (position-independent), then the march answers
    "whi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
    [leds.py, test_leds.py]
2026-07-31 feat(panel): Pi supervisor shell + systemd unit (raw lgpio)
    The thin Pi-only shell that owns all six front-panel LED lines: polls the sources
    (ingest heartbeat file, PiSugar battery over localhost, /run clock marker, systemd
    shutdown state), calls the pure supervisor_state()/led_states()/is_lit(), and writes
    GPIO at TICKS_PER_SEC. No judgement here — it lives in the host-tested pure modules;
    this is hardware glue, untested by design like restore_clock.py.
    Raw lgpio, NOT gpiozero: ADR 0002 already settled this box on raw spidev+lgpio after
    Pi 5's stack rejected Blinka and RPi.GPIO, and a second GPIO abstraction for six on/off
    pins isn't worth it — six claim_output/write calls. Epic 8's h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
2026-07-31 docs(panel): canonical INERT register; fix five stale facts + third state-path copy
    Three times in one day the same failure: one fact written in several places, one copy
    wrong, caught only by a human noticing. This makes the panel's inert-signal list
    canonical and removes the duplicated facts rather than re-syncing them.
    New "Panel signals designed but INERT" section — the ONE place saying which panel
    signals are wired end-to-end and which are not, as a table (signal / designed / why
    inert / how to activate). Named to match the string run_panel.py already cited: that
    reference was DANGLING (no such section existed), so the doc discipline had a hole in
    it before it was written down. Two en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
    [heartbeat.py, leds.py]
2026-07-31 docs: adopt "cite, don't restate" for literal values; backlog feat/drift-guards
    Three times in one session the same failure shape: a literal value written in several
    places, one copy wrong, caught only because a human happened to notice. The convention
    is free and already applied in this branch's doc pass — state literal values ONCE at
    their authority (paths, GPIO pins, I2C addresses, ports, thresholds) and CITE them
    elsewhere. A fact stated once cannot contradict itself. For prose procedures the tool is
    the same convention, not a test: no test can judge whether two procedures mean the same
    thing.
    feat/drift-guards is backlogged, NOT built, deliberately. The sanctioned deploy path
    (this b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
2026-07-31 feat(panel): finalise the panel map — LED_GPIO/COLOR into leds.py, order corrected
    The physical LED order was asserted in TWO files that could disagree — lamp_test_order()
    in leds.py and LED_GPIO/COLOR in the Pi shell — and they DID disagree, in 4 of 6 slots.
    Finding that cost a full bench session of single-LED probes. LED_GPIO and COLOR are pure
    data (name->int); they never needed lgpio and don't belong in hardware glue. Moved into
    leds.py beside lamp_test_order, with a host test asserting the three agree and reproduce
    the color sequence read off the real panel. That test replaces a physical probe with
    milliseconds on the Mac.
    Physical order corrected to the probed truth — pos1 GPI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
    [led_check.py, leds.py, run_panel.py, test_leds.py]
2026-07-31 docs(resume): panel-LEDs closed — map probed, supervisor deployed and enabled
    Marks the "assign the 6 panel-LED functions" next-step done, records the probed
    per-position map in the peripherals table, and refreshes the suite count to 221.
2026-07-31 docs: session close — panel-LEDs merged, 4.5 ungated, working rules, honest epic status
    Records the 2026-07-31 session and corrects several status claims that overstated what
    had been verified.
    feat/panel-leds merged (--no-ff, 6338aa9) and pushed; the six-LED supervisor is live and
    enabled for boot on apogee-gs. Branch cleanup done: 34 stale branches deleted, each
    verified an ancestor of origin/main BEFORE deletion and then removed with the safe
    `git branch -d` — two independent checks, 0 skipped, 0 refused. Mac, GitHub and Pi now
    carry `main` only. Backlog entry struck through with the method recorded.
    Honest status corrections — the same claiming-coverage-we-lack pattern removed fr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
2026-08-01 docs(resume): record the data-store owners; ops journal is the only irreplaceable artifact
    4.5 steps 2-3 ran against real data on apogee-gs and closed a provenance gap: the
    published flights.json already carried label/motor/field, but NO ops journal existed to
    reproduce them. Deriving from the real session reproduced every computed stat exactly and
    left those three fields empty — the artifact was un-re-derivable in precisely the way the
    2026-07-31 deploy drift was. Creating ~/apogee-data/ops-journal.jsonl closes it; rebuild
    is now verified byte-identical across repeated runs.
    Records the four files in ~/apogee-data/ and their single owners, because two of them look
    alike and only one is t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
2026-08-01 docs(resume): fix the Quarto preview command; record that QUARTO_PYTHON is discovery-only
    The recorded preview command mixed repos: `QUARTO_PYTHON=$(pwd)/.venv/bin/python3 quarto
    preview projects/lora-flights.qmd` only resolves if $(pwd) is THIS repo, but the .qmd
    lives in ~/velezf.github.io — which has no .venv at all, so the var expanded to nothing.
    Caught by Frank reading it before running it. Same cite-don't-restate failure class as the
    state path and the LED order: a command written where it could not be checked.
    Corrected to the verified invocation (run from the site repo, absolute path to this repo's
    render venv) and records WHY the var is needed, since the obvious reading is wrong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
2026-08-01 docs(resume): next-session handoff — OLED branch scope, rules, and the Quarto render fork
    Written as a budget safety net so the next session starts oriented after a context break,
    independent of whether Epic 4 closes in this one.
    Handoff block at the top of RESUME:
    - feat/oled-heartbeat, THREE admitted items as ONE branch, each with its why: periodic
    redraw (a quiet pad sits at luma's cleared-black init state and looks dead), an idle page
    with real content, and render OFF the RX thread (severity HIGH — a wedged I2C bus blocks
    packet handling today, so a DISPLAY fault can stop TELEMETRY CAPTURE). TDD the pure part,
    thin timer/threading glue, like ground/panel/.
    - The deferred red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
2026-08-01 docs(resume): 4.5 published and verified live — EPIC 4 CLOSED
    The LoRa flight archive is live at velezf.github.io/projects/lora-flights.html, published
    on F1's bench data alone, and the site repo is tagged v1.0-portfolio-genesis (4a7d15c).
    Epic 4 is closed: 4.1-4.5 done, 4.6 functionally done for SRC:1 with three clauses
    deferred to Epics 7/8 and the enclosure, 4.7 optional and not started.
    Verified end to end rather than merely built:
    - Actions run 30714197232 on sha bea974d, "Render Quarto site" step, EXECUTED not cached:
    Executing 'lora-flights.quarto_ipynb', Cell 1/3..3/3. The kernel resolved first try.
    - Public URLs 200 from a 404 baseline captured before the edits.
    - Served flight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
2026-08-01 docs(resume): tag lives on THIS repo, not the site; el-nino pre-pin baseline
    v1.0-portfolio-genesis was briefly placed on velezf.github.io and has been MOVED to this
    repo at 42eacb5 (deleted local + remote there, re-tagged here). Records why, so future me
    doesn't re-derive it or re-tag the wrong repo: the tag marks a state of the SYSTEM that
    produced the data — sled firmware, the ADR v1 packet contract, the native SX127x RX driver,
    the ingest service, the three-files/one-writer storage model, the AGL baseline, the
    field-time hardening, the fail-closed panel, the Stage-1 publisher — not a state of a
    website. The site repo is a publishing surface and carries no tags.
    Also records the pre-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
2026-08-02 feat(oled): split the render into a pure frame SPEC and a drawing layer
    The display is scheduled for a layout redesign (28px hand-drawn hero, inverted state band,
    trend strip, three pages). A `-> list[str]` renderer bakes the display's TEXT-ness into its
    tests — ≤4 lines × ≤21 chars are assertions about a font, not about meaning — so the
    redesign would delete the function and every test with it. Splitting now costs one
    dataclass and saves writing the frame logic twice:
    frame_spec(view, clock, tick) -> FrameSpec pure, stdlib-only, semantic
    render(spec) -> PIL.Image pixels; expected to be REPLACED
    frame_spec answers the two things the fix is about. A qui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
    [test_render.py]
2026-08-02 feat(oled): periodic redraw with UNCONDITIONAL re-init
    The OLED goes silently blank in two distinct ways and one periodic redraw covers both.
    1. No idle content — the old path rendered only on an observation callback, so a pad with
    no sled transmitting sat at luma's cleared-black init state and read as a broken box.
    Fixed by the redraw existing at all: it draws on a timer, not on traffic.
    2. Silent reset-blank — luma sends the SSD1306 init sequence ONCE, at construction. A
    display that loses power mid-session (a connector reseating in transit) comes back
    RESET: display off, CHARGE PUMP OFF, addressing and multiplex defaulted. It still ACKs
    on I2C, so luma keeps writing p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
2026-08-02 feat(oled): render OFF the RX thread — a display fault can no longer stop capture
    The correctness item of this branch. `registry.register(_oled_update)` drew the OLED
    SYNCHRONOUSLY inside the radio loop, so a wedged I2C bus — a luma write that never returns
    — HALTED PACKET HANDLING. A ~$10 display could stop the box's only job, telemetry capture,
    and stall the heartbeat into RED while the radio sat idle. Severity HIGH; this was a
    correctness requirement of the epic, not a nicety.
    Now the RX loop only PUBLISHES: `latest.view = _view_model()` on the same ~1 Hz tick that
    already publishes the LED heartbeat, so there is one cadence rather than two. A daemon
    thread is the ONLY thing that e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
2026-08-02 fix(oled): drop 0xAE from the periodic re-init — it was flashing the panel
    The re-init made the display visibly flicker once per second at the pad. Cause is one
    byte: _INIT_SEQ led with 0xAE (display OFF), so every frame turned the panel off, sent
    ~24 config bytes, turned it back on, then wrote the framebuffer. That is a real blank of
    ~1.5 ms at 400 kHz (~6 ms at 100 kHz), repeated at 1 Hz.
    Ruled out the other candidates: the framebuffer write cannot blank the panel (the SSD1306
    scans its own GDDRAM independently of writes — worst case is tearing, and the content is
    static), and the liveness glyph is a few pixels. Only 0xAE/0xAF change visibility; the rest
    of the sequence is idempotent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
2026-08-02 docs: OLED fix merged and verified live; item 3 closure bar; SRC-alias decisions
    feat/oled-heartbeat merged (52e5fe0). Records that all three items were verified LIVE on
    apogee-gs rather than asserted — the idle frame with its glyph cycling, a STEMMA QT reseat
    recovering clean, and the radio loop provably unharmed (heartbeat still published from
    inside the RX loop at ~1 Hz, dashboard still serving).
    Captures four things worth not re-deriving:
    - The re-init is unconditional because the fault is SILENT — a reset SSD1306 keeps ACKing
    and raises nothing, proven by a reseat that recovered with ZERO render errors. There was
    never anything for a triggered recovery to trigger on.
    - 0xAE was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
2026-08-02 feat(oled): pure redesign layer — hero overflow, freshness, pages, trend window
    The PURE half of the layout redesign. Every test is written against MEANING, never
    geometry: if a test here had to change when the hero font changes, it was written wrong.
    Scope is the closure bar's four questions and nothing else.
    Q2 how high — format_hero() owns the overflow policy in the PURE layer, so ">9,999 ft" is a
    testable decision rather than a font-size hack at draw time. Above 9,999 we switch UNITS
    (10.2k) rather than shrink or clip: shrinking breaks "readable at arm's length" exactly when
    altitude matters most, and clipping is a lie. TRUNCATES rather than rounds, so the hero can
    never OVERSTATE a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
    [test_render.py]
2026-08-02 docs: the two-surface rule, and the operator procedure it implies
    Records why the LED panel and the OLED are NOT peers, so the next "should this go on both?"
    question resolves without re-deriving it.
    The panel supervisor is its own process and SURVIVES the failures it reports — when ingest
    dies it sees a stale heartbeat and drives RED fail-closed. The OLED's render thread lives
    INSIDE apogee-ingest, so when that process dies the display freezes showing plausible
    content and cannot report its own death. Hence: LEDs answer "is the system working", the
    OLED answers "what is the flight doing", and the OLED must never be the authoritative
    reporter of a system-health fact.
    That rule decided cl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
2026-08-02 docs(resume): sampling/airtime facts, peak-source bug, and the beaconing blocker
    Backlog entries with MEASURED numbers attached, so the next session does not re-derive them.
    A — the ground throws away the sled's own answer. segmenter.py:78 computes peak from
    max(received ALT) while the dashboard/OLED use the sled's onboard Max: two peaks, two
    answers. The sled computes a running max at its sampling rate and transmits it in EVERY
    packet, so the ground needs any ONE post-apogee packet to be right, whereas max(received)
    loses the peak to a single drop at the wrong instant — silently, on the headline number of
    a public page. Admissible: passes (a) as a corrupted published record; passes (b)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
2026-08-02 fix(docs): correct the beaconing blocker — sentinel coalescing, not partial mutation
    The entry recorded in e3e6e7f was wrong, and the way it was wrong is worth keeping visible:
    the demonstration called FlightSegmenter.observe() DIRECTLY and bypassed the guard that
    actually exists. ground/flights/live.py:38-39 already coalesces, so the TypeError path is
    unreachable from the live flow and "partial mutation under a swallowed exception" is not the
    defect.
    The real defect is SENTINEL COALESCING — `None -> 0`, where 0 is a VALID value for both
    fields. Measured through the real consumer path on identical received frames with one beacon
    substituted mid-flight: packets_lost 0 -> 65,536 (gaps +=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
2026-08-02 feat(oled): hand-drawn 28px hero glyph set — 13 in-source bitmaps
    IN-SOURCE bitmaps rather than a committed PNG sprite or a TTF, for two reasons that both
    paid off on day one: a wrong pixel is caught in CODE REVIEW rather than by opening an image
    viewer, and it keeps the draw layer free of any asset-loading path that could behave
    differently on the Pi than on the Mac — the exact divergence that made us reject a system
    font and the reason golden-image tests are meaningful here.
    That first reason earned its place immediately. Two glyphs were WRONG PICTURES and the
    geometry tests passed the whole time, because both were well-formed rectangles of the
    correct height: `5` had a stray left ste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
2026-08-02 docs(resume): record the sentinel-collision CLASS with its sweep, and the open daylight check
    Records "sentinel colliding with a legal value" as an ARCHITECTURE class rather than three
    separate bugs: the v1 wire format has no way to express ABSENT distinctly from ZERO, and
    every ground consumer that coalesces None -> 0 inherits it. Max:0, SEQ->0 and ALT->0 are one
    defect shape.
    Targeted sweep of ground/ attached, because the blast radius turned out to be small and
    bounded: exactly TWO load-bearing sites (flights/live.py:38-39 on the live path and
    flights/derive.py:62-63 on the OFFLINE REBUILD path), with the remaining hits being counters
    that legitimately start at zero or display defaults o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
2026-08-03 docs: parallel-agent rules; correct two claims I asserted without running them
    First day of parallel agents. Records the rules that were paid for, and corrects two
    claims this file previously stated as fact.
    CLAUDE.md gains ELEVEN canonical parallel-agent rules, split by who they constrain — agents
    (exclusive Pi by construction, own worktree, no commits/pushes, no inline exploration,
    independent reports, no RESUME writes, explicit parking, base-commit disclosure) versus the
    main thread (scoped worktree gitignore, absolute-path discipline, verify-before-relay). Each
    carries its one-line reason. Agent prompts CITE the section by name rather than paraphrase
    it, same discipline as ADR 0003 an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
2026-08-03 fix(flights): absent is not zero — sled Max as peak source, coalescing removed
    Two defects of one shape: the v1 wire format cannot express ABSENT distinctly from ZERO,
    and the ground coalesced None -> 0 where 0 is a legal value for the field.
    PEAK SOURCE. segmenter.py computed peak from max(received ALT), discarding the sled's own
    running maximum which is transmitted in EVERY packet as Max. max(received) loses the true
    peak to a single dropped packet near apogee, silently, on the headline number of a public
    page; with Max, any ONE post-apogee frame carries the sled's answer. Proven against the real
    F1 log: delete its true-apogee frame and this yields -74 where the old code yields -75.
    TH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
2026-08-03 docs: rules 3 and 12 corrected; beacon policy; daylight approval; self-correction pattern
    Two rules needed fixing on the first day of parallel work, and both failures were the same
    shape — an unverified assumption that happened to be convenient.
    RULE 3 was wrong. It said agents never commit; that made their work unreviewable (there was
    no diff to read), unparkable under rule 7 (an uncommitted stream evaporates at session end),
    destructible by a stray checkout, and unverifiable (no hash to make claims about — which is
    what this project's whole discipline turns on). Corrected: agents COMMIT to their own
    branch, never merge, never push, never touch main. The gate is merge and push, which f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
2026-08-03 docs(rules): rule 3 corollary — merging an agent branch needs a main-thread commit first
    git merge on a zero-commit branch is a SILENT no-op: it reports success and changes nothing.
    The agent commits to its own branch; the main thread reviews that commit and merges. No path
    reaches main uncommitted, and none reaches it without a human-gated merge.
2026-08-03 feat(flights): beacons are counted and segregated, never merged
    Implements the decided policy: FRAMES THAT ARE NOT TELEMETRY DO NOT PARTICIPATE IN FLIGHT
    ACCOUNTING. A Part-97 CALL beacon is the station identifying itself — evidence the RADIO is
    alive, not evidence about the flight. This is the foreign-traffic rule of
    ground/ingest/core.py:12 applied to a second class of non-telemetry frame; that precedent is
    cited in the code, not restated.
    Two consequences, both decided by Frank:
    - packets_rx EXCLUDES beacons; they are counted separately as beacons_rx. A beacon carries
    no SEQ, so it cannot participate in loss accounting — in the denominator while absent from
    the sequence space it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
2026-08-03 feat(oled): three-page layout — Option A, with goldens generated after approval on glass
    The layout the redesign was for. Four bands: 8px header (identity + RSSI), 11px INVERTED
    state band, 28px hero, 10px trend strip. The trend strip is the sacrificial element — if a
    row is cramped the hero keeps its 28px and the strip goes.
    NO HARDCODED HORIZONTAL METRICS. Every x-position derives from text_width()/advance() at
    render time. That is not tidiness: the 4px stroke was approved on operator JUDGEMENT rather
    than a measured distance, so a redraw at 3px stays live, and a derived layout re-centres
    itself if that day comes. test_layout_survives_a_narrower_glyph_set proves it by swapping in
    a ha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
2026-08-03 docs(resume): flush the session backlog — Epic 6 prerequisites, absent-vs-zero, open items
    Everything left unwritten from a long session, recorded so none of it depends on
    conversation memory.
    EPIC 6 PREREQUISITES — two latent DEPLOYMENT hazards, verified by reading the code, neither
    an Epic 6 line item. apogee.h declares apogee on the first non-increasing sample and latches
    permanently, so one noisy boost sample would command a charge at max-Q irrecoverably; it is
    harmless today only because nothing is wired to it, which is what latent means. And
    main.cpp:89 returns from the whole loop on a failed barometer read, which would skip the
    tick that de-energizes a relay — a charge left hot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
2026-08-03 docs: land the Epic 6 plan and the draft-0004 frame-type ADR
    Two investigation deliverables from parallel streams, rescued from their worktrees before
    cleanup. Both are PLANS, not implementations — nothing here is built, and no Epic 6 work
    starts from this commit.
    docs/epic6-plan.md — 14 units across 6.1/6.2/6.3 in dependency order, marking which are
    hardware-gated and which are pure host-testable logic that can proceed now. Recommends ONE
    deployment event on a two-channel state machine with the second as a build-time flag, on the
    grounds that a main charge fires on absolute AGL — the one number never validated against a
    real climb — and that relay 2 has a competing use (the recover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
2026-08-03 docs: Epic 6 handoff — one deployment event, Phase 0 ordered b->c->a, external deps named
    Closes the session. Epic 4 is closed, the OLED redesign is merged, main is clean across all
    three copies with a single branch and no worktrees. No Epic 6 code has been written and none
    DECIDED — ONE DEPLOYMENT EVENT, on a two-channel machine, second as a build-time flag.
    Apogee-only is the standard L1/L2 configuration and what is actually being flown. The
    argument against dual-deploy now is the project's own recurring one: a main charge fires on
    ABSOLUTE AGL, and the only AGL number this system has ever produced is 10 ft from a hand
    swing. Committing a pyro to a number neve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
2026-08-06 feat(firmware): profile harness + confirmed apogee — the instrument, then the thing it measures
    6.0b and 6.0c, built in that order deliberately: you cannot validate hysteresis or dwell
    without a profile to run them against, and a latency claim should be an OBSERVATION rather
    than arithmetic.
    lib/profile — a synthetic flight profile with ANALYTIC ground truth (apogee time and altitude
    are exact, not sampled) plus a harness that runs any detector at any rate against the same
    profile. Simple physics on purpose: it is a repeatable ruler, not a simulation.
    lib/apogee/apogee_confirm.h — hysteresis (20 ft below the running max) AND dwell (300 ms held
    continuously). apogee::Detector declares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
2026-08-06 feat(firmware): sample at 20 Hz, transmit at 1 Hz — and stop one bad read killing the loop
    6.0a plus the main.cpp:89 fix, kept separate from the pure layer so it is revertible on its
    own if the bench goes wrong.
    SAMPLING AND TRANSMITTING WERE THE SAME LOOP, gated by delay(1000), so the detectors saw one
    sample per second. That is why the 2026-07-08 shake test's 2.2 g hand-jerk fell between
    samples and never tripped launch detection. Now the loop samples on a 50 ms tick and
    transmits on a 1000 ms tick.
    THE WIRE IS UNCHANGED. TX stays at exactly 1 Hz and the packet format is untouched, so the
    ground station needs no change, ADR 0001 needs no bump, and the e2e golden fixture stays
    valid. On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
    [main.cpp]
2026-08-06 feat(firmware): launch needs dwell too — 20 Hz makes the single-sample latch worse
    Caught by Frank before flashing, and it is the same defect as the apogee latch, mirrored.
    LaunchDetector set in_flight on a SINGLE sample over 3.0 g and never unlatched, so one
    transient permanently changed the flight state and every packet afterwards carried St:1
    whether or not anything flew.
    THE 20 Hz CHANGE MAKES IT MATERIALLY WORSE, which is why this had to land alongside it
    rather than after. At 1 Hz a knock had roughly a one-in-twenty chance of coinciding with the
    sampling instant. At 20 Hz the sled samples every 50 ms, so ANY transient wider than one tick
    is caught — and a hand-knock is 10-100 ms.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
2026-08-06 docs: field checklist, Epic 6 dissolved, flight-day record — 17.00 Hz MEASURED
    Flight day. The build being flown is 03d70aa, bench-verified clean against all seven abort
    checks: SEQ 193->307 with zero discontinuities, 0.0% loss over 115 packets, session opening,
    panel and OLED normal, baseline locked at -83 ft.
    THE SAMPLE RATE IS 17.00 Hz, MEASURED — not the 20 Hz targeted. Recorded as the measured
    value everywhere, with the reason: BMP390 conversion is ~25 ms at the configured oversampling,
    of which 16.3 ms is 8x TEMPERATURE oversampling that altitude never uses, plus the ADXL I2C
    read each tick. The harness says 20 Hz costs 33.8 ft of apogee-detection loss and 10 Hz costs
    36.2 ft, so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
2026-08-06 docs(epic6): TX-rate analysis — RF ceiling, ground impact, SF/BW trade
    Phase 1 deliverable for Epic 6 "maximum TX rate". Analysis only; nothing
    implemented, no hardware touched, firmware/src/main.cpp untouched (the
    main.cpp change is written out as a proposed diff in §9.1).
    Headline: the binding constraint is NOT the radio and NOT regulation. It is
    rf95.waitPacketSent(), which busy-waits for the full time-on-air so loop()
    cannot sample while it spins. The model 20 Hz x (1 - tx_hz x ToA) reproduces
    the flown 17.00 Hz to within 0.5%, which also contradicts RESUME's attribution
    of that shortfall to BMP390 oversampling (that explanation predicts 14.25 Hz).
    Unfixed, sampling falls below the 8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
2026-08-06 feat(firmware): launch confirm-or-revert — altitude decides, provisional never publishes
    The accel gate no longer declares a launch; it only decides when to START watching
    altitude. A provisional that never climbs REVERTS instead of latching forever, which
    closes the "no un-latch except a power cycle" hole.
    Measured against lib/profile at the sled's real 59 ms/sample:
    - a dwell separates a knock from a launch by a FACTOR OF TWO (100 ms fires on a
    177 ms knock; 300 ms needs 413 ms), so tuning it was tuning the weaker knob;
    - altitude separates them by THREE ORDERS OF MAGNITUDE (smallest motor +40 ft at
    0.5 s, +117 ft at 1.0 s; handling 0 ft, always).
    So the dwell stays at 100 m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
2026-08-06 feat(firmware): wire confirm-or-revert into the sample loop, backdate MET
    baroOk now feeds the launch detector as its altitude-validity signal as well as the
    failure counter: a read that did not answer must not be allowed to look like "altitude
    is not climbing", which is what would silently block confirmation.
    launchTime comes from launchDet.launch_ms(), which is BACKDATED to the accel gate.
    Using `now` here would charge MET for the entire confirmation window.
    Serial now reports the confirmation (with MET zero, the revert count, and whether the
    altitude path was unavailable) and adds launch reverts to the 5 s RATE line. A non-zero
    revert count on the pad is the sled saying it was knocked A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
    [main.cpp]
2026-08-06 docs: measured detector results, evidence-trust patterns 4 and 5, restated-fact 5
    MEASURED, not designed: ApogeeConfirm has a FIXED PRICE — 1.47-1.52 s and 34.8-37.0 ft
    across a 30x range of apogee altitude (442 ft to 13,390 ft), because the fall past apogee
    is free-fall and how high you got does not change how long it takes to drop 20 ft. The
    20 ft band costs 3.7x the 300 ms dwell (1.115 s vs 0.300 s), which inverts the design
    assumption: if apogee latency ever needs cutting, cut the BAND. And depth alone never
    fires — spikes at 5, 15, 19.9, 20.1 and 50 ft are all rejected — so the band's real job
    is stopping noise from ratcheting the running max, not rejecting spikes.
    PATTERN #4 —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
2026-08-06 docs(epic6): model the TX/sample coupling explicitly and cost the non-blocking fix
    Frank's constraint, worked out properly. Three additions.
    4.1 — the coupling tabulated under BOTH sample-cost models: TX rate ->
    blocking ms/s -> ticks lost/s -> achieved sample rate, for the typical 88 B
    frame (ToA 158.98 ms) and the saturated worst 113 B frame (194.82 ms).
    Frank's arithmetic reproduces exactly: 5 Hz x 194.82 ms = 974 ms/s, 97.4%
    duty, 0.52 Hz sampling. Sampling crosses below the 8 Hz abort floor between
    2 and 3 Hz worst-case. THAT is today's real ceiling, not the 5.13 pkt/s
    airtime figure.
    4.2 — the two models are carried side by side rather than one being asserted.
    Model A (50 ms tick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
2026-08-06 test(firmware): pure 9-DoF conversions — sensitivity tables, tilt, gyro bias
    RED first: 20 host tests against imu.h before it existed, then the
    implementation. Suite goes 34 -> 54 cases, all green in `pio test -e native`.
    The lib/ split earns its keep here specifically because every failure this
    layer can have is SILENT IN THE DATA — a wrong sensitivity constant yields a
    plausible roll rate, an unfolded tilt angle yields a plausible attitude, a
    bias averaged over a bumped pad yields a plausible zero. None of them raise.
    So they get pinned on the ground, where they can still fail.
    Two decisions are asserted rather than assumed:
    - tilt FOLDS to 0..90, so nose-up and nose-down read the sa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
2026-08-06 feat(firmware): declare the 9-DoF libraries and add the I2C transport glue
    Closes the ambient-state half of docs/epic5-integrity-note.md. The libraries
    were not merely unpinned, they were ABSENT from lib_deps entirely — nothing
    but a local Arduino IDE install could ever have satisfied them.
    Verified by RESOLUTION, not by eyeballing the ini. `pio run -e feather_m0_tx`
    now prints them in the dependency graph and links:
    |-- Adafruit LSM6DS @ 4.7.4
    |-- Adafruit LIS3MDL @ 1.2.5
    Trap worth naming: flash size did NOT change when imu9dof.cpp was added,
    because nothing references it yet and the linker drops it. Size parity is
    therefore not evidence the file compiled. Verified the reliable wa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
2026-08-06 feat(firmware): committed one-shot I2C census + the unapplied main.cpp patch
    The integrity note's point was never that the 5.1 reading was wrong — it was
    that no checkout can rebuild the artifact that produced it. The fix for that
    is an artifact with a SHA, not a better note. `[env:i2c_scan]` builds only
    tools/i2c_scan and links no main.cpp (verified: the build produces no src/
    objects at all).
    The scan is a one-shot by construction because the main thread gets one
    round-trip: three passes per address (so a marginal pull-up reads 2/3 instead
    of a clean present/absent lie), identity-register probes at every address a
    known part can occupy (an ACK proves only that SOMETHING is there), and b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
    [i2c_scan.cpp]
2026-08-06 docs: the sensor census — six devices, two read, and where the 3 Hz went
    0x6C/0x3D RESOLVED: they are not I2C addresses at all, they are WHO_AM_I
    values (LSM6DSOX chip id, LIS3MDL part id), confirmed twice from independent
    library copies — the versions pio resolves today and the vendored copies
    deleted in c1b955c. The parts live at 0x6A and 0x1C. Flagged prominently that
    0x3D IS separately a real address — the Pi's OLED, a different bus on a
    different machine — so the next reader does not merge the two facts.
    The loop-timing claim is CONFIRMED IN ARITHMETIC AND REFUTED IN CAUSE. The
    BMP390 numbers reproduce exactly from the datasheet formula (25.03 ms total,
    16.32 ms of it temperatu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
2026-08-06 docs(census): packet budget for gyro+mag — 128 B overflows, and it fails SILENTLY
    Every option overflows, including the minimal already-reserved Roll+Spin pair
    (130 B against 128). C (gyro+mag) needs 176; D needs 208; increment-2's
    Ax/Ay/Az plus gyro+mag needs 224. The ceiling is 251, not a free choice:
    RH_RF95_MAX_MESSAGE_LEN, above which send() transmits NOTHING and main.cpp
    ignores the return.
    The encoder itself is safe — snprintf is bounded and reports bytes actually
    written, verified in source. The hazard is downstream and it is worse than a
    dropped packet: tested against the repo's own decoder, 9 of 13 truncation
    points are ACCEPTED with no counter moved. Four carry a well-formed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
2026-08-07 docs(adr): ADR 0005 — 10 Hz at SF7/BW500, ACCEPTED with its gate measured
    The target is an OpenRocket-style plot, which is a RESOLUTION requirement: at 1 Hz a
    20 s flight is 20 points. That reframes "faster" as "enough points to draw a curve
    through", and it is the first requirement the wire itself cannot satisfy.
    Bandwidth is the only knob left. CR is already minimal at 4:5. SF6 is rejected on
    MECHANISM, not margin: it requires implicit-header fixed-length packets, which either
    pads every frame to worst case (spending the airtime SF6 was meant to save) or freezes
    the field set, destroying ADR 0001's additive evolution. SF6 buys speed by removing the
    property that makes the format surviva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
2026-08-07 docs(checklist): LID OFF is a Wi-Fi rule too; the two antenna rules are OPPOSITE
    LID OFF was already the thermal rule. It is also the connectivity rule: the Pi 5's
    built-in Wi-Fi sits inside the metal box and, unlike the LoRa radio, CANNOT take an
    external antenna. A closed lid kills the hotspot link and it presents as "the dashboard
    is broken". Same action satisfies both rules; sealing the box ever means vent holes AND
    a USB Wi-Fi dongle.
    But shielding is not the first suspect at home: measured 2026-08-06 with everything
    mounted in the box, the home AP scanned at signal 100. Both actual causes were software
    and invisible from the symptom — `nmcli radio wifi` was `disabled` (an NM-level s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
2026-08-07 docs(resume): handoff block for the 10 Hz build session
    NOTHING FLEW ON 2026-08-06 — the "FLIGHT DAY" section describes what was prepared, not
    what was flown, and now says so. The flight is pigtail-gated.
    Records the seven-step build order (WINDOW time-based -> truncation loud + buffer 192 ->
    temp 8x->1x measured -> non-blocking TX -> Vel + G envelope -> both-ends BW500 ->
    St-dependent 10 Hz), each with the specific trap already identified: isSending() does
    not exist on RH_RF95; seq must not increment on a skipped send; the both-ends BW
    constant fails as SILENT TOTAL LINK LOSS; and St-dependent rate never turns off because
    the flight states latch and there is no St:3.
    Red-team-before-fla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
2026-08-07 docs: close Epic 2.2 — hotspot validated router-off; Epic 2 fully closed
    Validated 2026-08-07 with the router OFF and Ethernet down: the Pi ran on the phone
    hotspot alone and served the dashboard by IP (172.20.10.2) and by name
    (apogee-gs.local), both HTTP 200, while sled reception continued at 0 loss. No home
    infrastructure was in play, which is what removed the need for a separate field trip —
    the parked item is closed rather than carried.
    ONE EDGE IS UNTESTED AND NAMED RATHER THAN HIDDEN: the association was forced with
    `nmcli connection up`, so unattended rejoin on a cold boot has not been observed, and
    that was 2.2's literal acceptance clause.
    CLOSED ANYWAY, ON A RISK ARGUMENT RAT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
2026-08-07 docs: standard saved-network verification; resolve the vanishing-profiles question
    CHECKLIST — adds the four-field check for any Wi-Fi the box must join unattended.
    Three of the four fail SILENTLY: `connection.permissions` non-empty means user-scoped, so
    it connects only while that user is logged in and at boot nobody is; `psk-flags` 1 means
    "ask an agent" and there is no agent at boot; `connection.timestamp` 0 means the profile
    has never once associated while existence, priority and a plausible password all still
    read fine. The timestamp is the only one of the four that describes HISTORY rather than
    intent, and it is what caught this profile.
    RESUME — records the persistence mechanism,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
2026-08-07 docs(resume): correct baseline.py path — ground/flights/, not ground/
    The handoff block cited ground/baseline.py from memory; the file is
    ground/flights/baseline.py. A restated fact inside the very list that warns about
    restated facts — found because the reconciliation check greps before it trusts.
2026-08-07 feat(decode): ten additive v1 tags — Vel, Gmx/Gmn, Wmx, raw 9-DoF channels
    The E+F frame-shape decision (2026-08-08 session, pending ADR 0001 rows):
    FLIGHT frames add Vel/Gmx/Gmn/Wmx, PAD frames add Vel/Gmx/Gmn plus
    Gyx/Gyy/Gyz/Mgx/Mgy/Mgz. All ten are unitless floats mirroring G/Pg —
    exact-key entries in _V1_TAGS, no unit suffix, same bad-value error class.
    Unknown-tag tolerance and missing-tag legality unchanged.
    TDD: 22 failures red (tags landed in unknown{}), green after the table rows.
2026-08-07 docs(contract): collision proof for the ten new tags, with executable pins
    Census of every site that special-cases a tag NAME or frame KIND across
    decode -> ingest -> segmenter -> derive -> export/publish -> dashboard model:
    all matching is exact whole-key; no prefix/substring matching anywhere.
    Verdict: NO COLLISIONS for Vel/Gmx/Gmn/Wmx/Gyx/Gyy/Gyz/Mgx/Mgy/Mgz, and the
    Appendix A rules hold (multi-char, no v1 reuse, Roll/Spin left for fusion).
    Properties a test can pin are pinned in test_newtag_collision_proof.py (11
    tests, anti-hollow: the flat counters are shown able to move). Findings
    reported, not fixed: export.py's fixed column list silently drops the new
    tags from the published CSV;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
2026-08-07 feat(flights): pad-baseline window becomes TIME-based — 15 s at any packet rate
    ADR 0005 §7: WINDOW = 15 was a SAMPLE count calibrated in seconds at the
    ~1 Hz ground rate; at 10 Hz TX the AGL baseline silently locked on 1.5 s
    of data. Demonstrated against the old code: 17 s of handling motion + 3 s
    of quiet at 10 Hz returned (-84, 15) — a locked baseline on a rocket
    still in motion. Time-based, the same wall-clock window holds at any rate.
    - baseline.py: pad_baseline takes time-ordered (t, alt) pairs; WINDOW/
    EXCLUDE_TAIL -> WINDOW_S = 15.0 / EXCLUDE_TAIL_S = 2.0 (renamed so no
    consumer silently reinterprets a count as seconds). MAX_STDEV unchanged.
    trim_history replaces the coun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
    [test_baseline.py]
2026-08-07 docs(adr): ADR 0005 Amendment 1 — E+F frame split, §4 worst-form correction, binary-v2 trigger
    The 9-DoF fit measurement (STOP at the pre-agreed 65% duty line: no 3-axis
    representation fits the 14 B budget) and the decision it forced: flight frames carry
    the |gyro| envelope Wmx (152 B, 64.1%), pad frames carry raw 9-DoF channels at 1 Hz
    (210 B, 8.5%) as the calibration dataset. Aliasing rationale recorded: at 10 Hz the
    in-flight raw channels were aliased at any encoding, so binary would have shrunk the
    frame without restoring the signal.
    Corrects §4's Gmn worst form (longest form governs, not the value floor): base is
    141 B, not 139 — ToA survived only by symbol-group quantisation, so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
2026-08-07 docs(epic5): Teensy 4.1 sled respin — plan, closed question, C2 dissolves into SD
    Records the direction decision: Epic 5 becomes the Teensy 4.1 respin (onboard Mahony
    + SD flight recorder), gated FIRM on F2 flying the 10 Hz Feather build first — no MCU
    respin stacks onto an unflown RF rewrite, because two revolutions with no flight
    between them means unattributable failures.
    The closed question is recorded with its arithmetic and its load-bearing leg named:
    duty kills ASCII (352%) and per-sample binary (77-103%) at 50 Hz, but BATCHED binary
    is 32% — so duty alone does not close it. What closes it at any encoding is
    integrator integrity: ground-side fusion integrates a lossy RF link an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
2026-08-07 feat(rx): Pi receiver bandwidth default 125 -> 500 kHz (ADR 0005)
    One constant: LoRaConfig.bandwidth_khz. Authority is
    docs/adr/0005-telemetry-rate-and-rf-configuration.md (cited, not
    restated). _BW_CODES already carried 500 (code 0x9); new unit tests pin
    the exact RegModemConfig1 byte for BW500/CR4:5/explicit-header (0x92)
    and pin the default itself to the ADR 0005 flight config, both shown
    failing against the old constant first.
    *** DEPLOY HAZARD — DO NOT DEPLOY THIS TO THE PI YET ***
    This is the both-ends restated-fact hazard of ADR 0005 §7: the
    SLED-side bandwidth constant is Phase 2 item 8 and is NOT yet changed.
    This commit makes the repo BW500-ready but MUST NOT reach the ground
    s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
    [sx127x.py, test_sx127x.py]
2026-08-07 test(flights): e2e fixtures for both frame shapes + PAD-frame-mid-flight
    Worst-FORM FLIGHT and PAD frames (every value at its longest legal rendering;
    measured 151 B / 209 B on the wire — the decision's 152/210 counts the C-string
    NUL) and a 28-packet transition session: quiet 1 Hz pad, 10 Hz flight, one
    St:0-shaped pad-content frame BETWEEN St:1 frames with SEQ continuous.
    Derive over the transition proves the additive rules carry it: one flight (no
    split), packets_rx 10 including the St:0 frame, 0 lost across it, peak 905
    from Max with the frame's Max:0 gated out, baseline -84/15. Red evidence:
    all three decode-equality tests fail against the base-commit decoder.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
2026-08-08 docs(contract): F1 byte-identity proof — six identical SHA-256s, completed post-agent
    The authoring agent was terminated by the account spend limit after computing the
    hashes but before committing this section; the main thread reviewed the full diff and
    committed it as written. The byte-identity claim was independently corroborated by the
    main thread before this commit: zero-line git diff on both F1 fixture files between
    main and this branch, zero new-tag tokens in f1_session.jsonl, and the F1 golden 4/4
    on both sides — so the six-hash table is agent evidence with an independent cross-check,
    not a relayed claim (parallel-agent rule 11).
    CARRIED FORWARD AS A NAMED RED-TEAM TARGET: the co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
2026-08-08 docs: jitter rider re-triggered on the lander, one-sled field rule, bench-traffic note
    Correction from Frank (2026-08-08): the two sleds never transmit simultaneously in the
    field — one rocket flies at a time, the other sled is powered off, the handheld is
    RX-only — so sled-coexistence collision design (listen-before-talk, jitter-for-sleds)
    was over-engineering for a scenario that cannot occur. The ±10% TX jitter rider goes
    back to backlog with its trigger corrected: it revives when the LANDER (SRC:2), the
    node designed to transmit concurrently with a sled, becomes real.
    Replaced by one operational rule in the field checklist: ONE SLED POWERED AT A TIME at
    the range. What survives is i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
2026-08-08 feat(firmware): encode_packet truncation is LOUD; buffer 128 -> 256 per E+F
    Phase 2 item 1. The old contract returned out_len-1 on overflow — a valid-looking
    length — and the fragment went to air, where it DECODED: measured 2026-08-07, a frame
    cut at 105 B yielded a valid packet with MET:6 against a true 65535, no counter moved.
    New contract: 0 on any truncation, buffer emptied, so a caller that ignores the return
    transmits nothing rather than a lie. No real frame is 0 bytes, so 0 is unambiguous.
    main.cpp: msg[256], sized to the LARGEST frame of the E+F split — the 210 B pad frame,
    not the 152 B flight frame — under the 251 B RH_RF95_MAX_MESSAGE_LEN cap, with the
    range-assumption de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
2026-08-08 feat(firmware): BMP390 temperature oversampling 8x -> 1x — with the corrected justification
    Phase 2 item 2. 1x via BMP3_NO_OVERSAMPLING (0x00 = one conversion, no extra samples —
    the name does not mean 'no temperature'). NOT temp-off: BMP3 pressure compensation
    requires the temperature term (temp_en is unconditional in performReading), so only the
    oversampling drops — 16,323 us -> 2,183 us, a 14.14 ms saving, not the 16.3 an earlier
    estimate claimed.
    The justification is deliberately NOT 'raises the sample rate'. Two agents
    independently established (2026-08-07) that performReading() never waits for the
    conversion — the 17 Hz loop was waitPacketSent()'s fault, not the barometer's. T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
    [main.cpp]
2026-08-08 feat(firmware): non-blocking TX — the sample loop no longer stops for the radio
    Phase 2 item 3. The TX path was send() + waitPacketSent(), blocking the firmware's one
    thread for the whole time-on-air — measured ~33 ms of every 59 ms sample period at 1 Hz,
    and fatal at 10 Hz (974 ms/s of blocking). RadioHead's send() is already async-start
    (verified from source: the wait was OURS); it needs guarding because send() opens with
    its own waitPacketSent (RH_RF95.cpp:334). The guard is mode()==RHModeTx, ISR-maintained,
    no SPI cost (RHGenericDriver.h:224, enum at :53 — isSending() does not exist on RH_RF95).
    Policy lives in lib/txgate (pure, host-tested, 6 tests):
    SEND — radio i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
    [main.cpp]
2026-08-08 feat(firmware): per-sensor read isolation — separate counters, time-based health
    Phase 2 item 4. Each sensor's failures are counted separately (the RATE line can say
    WHICH bus peer is sick) and health is a per-sensor question the frame builder can ask —
    item 7's pad frame omits 9-DoF tags from an unhealthy sensor, because missing tags are
    v1-legal and garbage values are not.
    Health is TIME since last good read (500 ms), not a count of consecutive failures — a
    count threshold means different things at 22 Hz and 1 Hz, the criterion-redefinition
    the constants-in-time rule exists to prevent. Only SUCCESS refreshes the clock (the
    stuck-baro lesson: failed attempts must not look like livene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
    [main.cpp]
2026-08-23 docs: pigtail repair CLEARED (−40 dBm, zero loss); wedged-radio hardening candidate
    RESUME: the DEFERRED list is no longer pigtail-gated — repair validated by Frank
    2026-08-08, remaining items are flight-gated. Records the SX127x wedge (3.7 h of
    nothing decoded under a healthy ingest) as an admission-rule candidate.
    ADR 0005 §2: the "design assumption" caveat is retired with the measurement and
    the waived checks named.
2026-08-24 feat(firmware): Vel + G envelope (Gmx/Gmn) — additive v1 tags, envelope reset-on-air
    Build-order step 5 (ADR 0005 §4/A1.4). Two new pure units: velocity::Estimator
    (dh/dt, irregular-interval EMA, tau in TIME not samples — validated against
    lib/profile's analytic derivative, not the estimator's own model) and
    envelope::Window (min/max |g| per TX window; reset ONLY when a frame goes to
    air, so a TX skip or encode drop extends the window instead of losing a spike).
    Encoder appends Vel/Gmx/Gmn after MET, byte-matched to the merged decoder
    fixtures; the ADR 0001 12-tag golden is pinned as an exact byte prefix and the
    A1.4 saturated frame is pinned at 141 B. 76/76 native, target compiles.
    Wmx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
    [main.cpp, test_envelope.cpp, test_packet.cpp]
2026-08-24 feat(firmware): both-ends BW500 cutover — sled to SF7/BW500/17 dBm, cross-end guard
    Build-order step 6 (ADR 0005). The ground station has run the flight config
    since the newtags merge; this is the sled half of the coordinated cutover.
    RF constants move to lib/rfconfig/rf_config.h (pure, ADR-cited); main.cpp
    selects Bw500Cr45Sf128 loudly, static_asserted against the header, and TX
    power drops 23 -> 17 dBm per ADR 0005 §2 (same decision, thermal at 58.9 %
    duty). "One authority, cited" is now MECHANICAL: test_rf_both_ends.py parses
    the sled header and compares it to LoRaConfig's deployed defaults, so either
    end drifting alone fails a test instead of failing as silent link loss.
    Anti-hollow: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
    [main.cpp, test_rf_both_ends.py]
2026-08-24 feat(firmware): St-dependent TX — 1 Hz pad / 10 Hz flight, MET-bounded fast window
    Build-order step 7, the last build step of ADR 0005. lib/txsched: stateless
    interval_ms(in_flight, now, launch_ms) — 1 Hz pad, 10 Hz flight, reverting at
    FAST_WINDOW_MS (300 s) from MET zero. The bound exists because the flight
    states latch and there is no St:3: without it "fast in flight" keys the PA at
    58.9 % duty until the battery dies. 300 s is CHOSEN, NOT MEASURED (~2x the
    worst realistic flight; rationale beside the constant) — flagged for review.
    Stateless so there is no anchor to re-anchor; the contract is pinned by test.
    The wrap test caught a real host/target divergence: unsigned long deltas ar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
    [main.cpp]
2026-08-24 fix(firmware): apogee detector fed only on answered baro reads
    Red-team finding 6 (pre-existing at base, load-bearing at 10 Hz): haveSample
    read like a validity gate but was a boot-latch — never cleared — so a failed
    performReading() replayed the last altitude with a FRESH timestamp into
    apogee::Confirm's time-based dwell. Scenario: one real noise dip >=20 ft
    below the running max, then a >=300 ms baro wedge, and St:2 confirms and
    latches mid-ascent from a sensor that wasn't answering. Now gated on baroOk —
    the same discipline velEst and launchDet already follow — and the dead
    haveSample flag is removed. Wiring-level fix; the pure detector is unchanged.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
    [main.cpp]
2026-08-24 fix(firmware): modem registers derived from rf_config.h — the weld is mechanical
    Red-team finding 1 + finding 8 residuals. The old static_assert compared
    rf_config.h's constants to LITERALS while the ModemConfigChoice enum could be
    reverted alone — every guard green, sled at BW125 against a BW500 ground,
    silent total link loss. Now there is no enum: main.cpp programs registers
    derived at compile time from rf_config.h, formulas mirrored from
    ground/rx/sx127x.py and pinned case-for-case against the ground's own
    register tests (test_rfconfig: 0x92/0x74/0x04, SF9/BW250/CR48 mirror, LDRO
    threshold, loud-invalid bandwidth). rf_config.h gains CRC_ON / SYNC_WORD /
    PREAMBLE_LEN (previously uncomp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
    [main.cpp, test_rf_both_ends.py]
2026-08-25 test(firmware): velocity noise rejection asserted, not assumed
    Red-team finding 5: every velocity test drove noise-free signals, while ADR
    0005 §4's whole justification for onboard Vel is noise behaviour. New test
    injects deterministic (seeded LCG) ±2 ft baro-like jitter into the profile
    and bounds the output directly: RMS < 15 ft/s, worst < 40 ft/s over the coast
    phase — and it is anti-hollow twice over: the raw ground-side dh/dt under the
    same noise must exceed 30 ft/s worst (proves the injection injects) and the
    smoothed output must beat raw by >2x (asserts §4's claim itself). 9/9.
2026-08-25 fix(firmware): stale prose corrected; sensor health verdict consumed
    Red-team findings 7 and 9. The 6.0a-era "THE WIRE IS UNCHANGED / TX stays at
    exactly 1 Hz" block sat ten lines above the txsched citation contradicting it
    — rewritten to the current truth (St-dependent TX, three additive tags, all
    v1-legal, ground decodes them). The 256 B buffer comment described the
    not-yet-built 210 B 9-DoF pad frame as current — now states today's pinned
    141 B worst case and marks 210 B as what the size is AHEAD for. And
    sensorHealth.healthy() gains its first consumer: the RATE line now prints the
    time-based baro verdict, so a wedged-but-rarely-failing baro is visible on
    the bench instead of the verd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
    [main.cpp]
2026-08-25 fix(ground): SX1276 high-BW sensitivity optimization registers at BW500
    Red-team finding 8 (pre-existing, surfaced by the BW500 hunting ground):
    configure() never wrote the SX1276 errata §2.1 registers, so RX sensitivity
    at 500 kHz sat below the datasheet figure ADR 0005's link budget assumes —
    silently spending margin on top of the 6 dB the ADR already spends. Now:
    0x36=0x02 with 0x3A=0x7F in the 410-525 MHz band (0x64 for 862-1020 MHz) at
    BW500, and 0x36=0x03 (automatic) restored for every other bandwidth, 0x3A
    chip-managed. TDD: three tests written red first, including the non-500
    restore path. REGISTER VALUES ARE FROM THE ERRATA SHEET BY RECOLLECTION —
    verify against the published d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
    [sx127x.py, test_sx127x.py]
2026-08-25 chore(ci): both guard suites run on every push — guards a human must remember are inert
    Red-team finding 8: no CI existed, so the cross-end RF guard and the native
    suite ran only when someone remembered — the designed-but-inert class this
    repo already tracks, in the two checks whose failure mode is silent link
    loss. Two jobs: pio test -e native, and the ground unittest discovery
    (pillow+pytest; lgpio deliberately absent — Pi-only runtime dep, no test
    imports it, and a future one fails loudly here). UNVERIFIED UNTIL THE FIRST
    PUSH EXECUTES IT — stated in the file itself; evidence must describe the
    running artifact.
2026-08-25 docs: cutover ordering, bench protocol additions, ADR status honesty (findings 2-4)
    Red-team findings 2, 3, 4 — the process half of the nine. RESUME gains the
    2026-08-25 handoff: main is cross-end inconsistent TODAY (ground BW500 since
    d53b9a6, sled BW125), so the merge/deploy/flash ordering is documented as the
    cutover it is, with "a dark bench between steps is EXPECTED" stated before
    anyone burns hours on a phantom wedged radio. Bench protocol now requires the
    sustained-10 Hz FIFO-overwrite evidence (A1.6) and ground-side inter-arrival
    monitoring (SKIPs do not gap SEQ, so wedge-degradation reads as 0 % loss).
    ADR 0005's status line now says what §8's measurement covered (1 Hz arrival)
    a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
2026-08-25 feat(firmware): clearly-labeled bench build — BENCH_FORCE_FAST_TX for the A1.6 measurement
    The A1.6 sustained-10 Hz bench cannot honestly run on the flight build: fast
    TX engages only in confirmed flight, which a bench cannot induce without
    changing what is measured. New env feather_m0_tx_bench extends the flight env
    with -DBENCH_FORCE_FAST_TX: interval_ms returns the fast interval
    unconditionally — RF path, loop and ground pipeline are the flight build's;
    only the schedule's INPUT differs. Labeled three ways: its own env name, a
    boot banner on serial every start ("NOT FLIGHT FIRMWARE"), and
    test_txsched_bench pinning the flag semantics via a test-local define (red
    first: 2 failures). Th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
    [main.cpp]
2026-08-25 docs: A1.6 measured — 9.91 pkt/s / 0.087% loss / 17.4 min; wedge + 9-DoF queue recorded
    ADR 0005 A1.6 goes from *pending bench* to measured (2026-08-25, bench build
    7d5119b, 17.4 min, 10,318 packets): 20.00 Hz sampling, 9.91 pkt/s sustained,
    inter-arrival p99 107 ms, loss 0.087% all single-packet FIFO-overwrite class,
    0 skips/forced/overflows, RSSI -53.3 sigma 0.79. Honest edges kept visible:
    battery draw NOT measured (USB bench), RX turn closed by arrival evidence
    rather than per-turn instrument, field-range margin flight-gated. RESUME
    records the reproducible flash-reset wedge (2x, power-cycle recovers, I2C
    mid-transaction hypothesis, bus-clear queued as candidate fix), the
    monitor-detac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
2026-08-25 feat(firmware): E+F frame split — the shape is derived from St, goldens are the ground's own fixtures
    ADR 0005 A1.3/A1.4. Pad frames (St:0): base + raw Gyx/Gyy/Gyz/Mgx/Mgy/Mgz —
    Epic 5's stationary calibration record. Flight frames: base + Wmx. The shape
    is DERIVED from p.state inside the encoder — no shape field exists, so shape
    and flight state cannot disagree by construction. Byte-for-byte goldens are
    the ground decoder's merged worst-frame fixture strings (both languages now
    pin identical bytes); worst-case sizes pinned at A1.4's 152/210 B with the
    worst-FORM subtlety documented (G's negative bound is one byte longer than
    the fixtures' positive values). Truncation stays LOUD throug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
    [test_packet.cpp]
2026-08-25 feat(firmware): LSM6DSOX + LIS3MDL read path — Wmx envelope, pad-frame raw channels
    Addresses per docs/RESUME.md:457 (0x6a / 0x1c). Gyro feeds a second
    envelope::Window every 20 Hz sample tick (rad/s -> dps; ±2000 dps FS), so
    Wmx is alias-free at any TX rate; raw gyro+mag (µT, ±4 gauss FS) are held
    for the 1 Hz pad frame. wEnv resets only when a frame goes to air — the
    gEnv discipline. Init parks LOUD on failure like every other sensor
    (flagged: enrichment-vs-park is arguable). CORRECTED restated fact:
    sensor_health.h claimed the LSM6DS/LIS3MDL drivers report read success —
    the vendored sources return true unconditionally over a void _read(), same
    as the ADXL, so IMU6/MAG stay delib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
    [main.cpp]
2026-08-25 fix(firmware): red-team dispositions — enrichment sensors DEGRADE, magnitude range truth pinned
    Findings 1, 3, 4, 5 (dispositions approved 2026-08-25). DEGRADE, NOT PARK:
    a failed LSM6DSOX/LIS3MDL init drops that sensor's tags (missing tags are
    v1-legal) with a loud serial line, instead of holding the sled in while(1)
    at the pad — where a battery connect is a power cycle and the reset wedge
    is a known repeat offender; BMP390/ADXL stay loud parks (they ARE flight
    decisions). The encoder owns the omission (has_imu6/has_mag), every append
    keeps the LOUD-truncation contract, and the degraded shapes are pinned
    red-first (imu6-less flight and pad, mag-less pad, base-only pad).
    RANGE TRUTH: Wmx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
    [main.cpp, test_packet.cpp]
2026-08-25 docs: A1.4 magnitude bounds corrected; silent 9-DoF death recorded as a named hazard
    Red-team findings 2 and 3, doc half. A1.4's Gmx/Gmn/Wmx rows now state the
    vector-magnitude worst cases (346.4 g / 3973.0 dps) the wire actually
    carries, with the same-formatted-length coincidence called out and pinned in
    test. RESUME gains the named open hazard: the vendored 9-DoF drivers discard
    I2C status and parse an uninitialized buffer on failure, so an in-flight
    sensor death freezes or fabricates spin data with no wire evidence — Epic 5
    must treat a constant spin trace as suspect. Fix path queued with the I2C
    work, after the bench, per Frank.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
2026-08-25 docs: feat/firmware-9dof bench-verified — 20.00 Hz held with 9-DoF, physics checks pass
    RESUME's queue entry becomes the record: pad frames carry the full raw tail
    at 1 Hz (mag vector ~40 µT — real Earth field, not noise; gyro <=1 dps
    stationary, +/-110 dps under a hand rotation with launch reverts 0), no Wmx
    on pad, unknown:{} clean, and RATE 20.00 Hz achieved ON THIS ARTIFACT —
    closing the red team's evidence caveat that the prior 20 Hz number described
    the pre-9-DoF build. Awaiting merge gate.
2026-08-25 fix(firmware): I2C bus-clear before Wire — the wedge fix, built as an instrument
    The reproducible flash-reset wedge (RESUME 2026-08-25, 2x, power-cycle-only
    recovery) has a hypothesized mechanism: reset lands mid-I2C-transaction, a
    slave holds SDA low, init fails into while(1). Standard remedy applied — up
    to 9 SCL pulses until SDA releases, then a STOP, before any Wire user. And
    DELIBERATELY AN INSTRUMENT: every boot prints "clean" or "SDA STUCK LOW,
    released after N pulses", so the next post-flash boot either catches the
    mechanism in the act or, over many silent flashes, argues against it. Today
    we have the hypothesis and no evidence either way; this converts every
    future flash into a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
    [main.cpp]
2026-08-25 feat(firmware): status-bearing 9-DoF reads — health enrollment, in-flight degrade
    Retires RESUME's named hazard (red-team finding 2): the vendored getEvent()
    paths discard I2C status and parse an uninitialized buffer on failure, so a
    dead sensor could freeze or FABRICATE spin data with no wire evidence. Data
    reads now go through Adafruit_I2CDevice.write_then_read (real I2C status):
    a failed read updates NOTHING, sensors::Health counts it (IMU6/MAG enrolled
    — sensor_health.h's coverage note updated again to match reality), and
    has_imu6/has_mag become HEALTH-driven, so a sensor dying mid-flight drops
    its tags within ~stale_ms instead of masquerading as data. Failure counts +
    verdicts ride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
    [main.cpp]
2026-08-25 fix(firmware): red-team dispositions — three-state bus verdict, persisted; honest equivalence
    All five findings + two notes (dispositions approved 2026-08-25). The bus
    instrument now reads SCL as well as SDA and reports three states — clean /
    SDA-stuck-released(N) / SCL-STUCK(power-cycle, unclearable from the master)
    — so a clock-stretch wedge can no longer print "clean" and feed the wrong
    arm of the experiment (F2). The verdict is PERSISTED and echoed on every
    RATE line (F4: one-shot boot prints land in the exact post-flash observation
    gap that already ate two failure lines). Pulse drive order fixed: OUT set
    low before the pin becomes an output, so no push-pull-HIGH blip (F5), and
    the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
    [main.cpp]
2026-08-25 docs: first unaided post-flash boot — bus verdict clean, mag re-proven on 0xA8
    Bench record for feat/i2c-hardening (e8f2f4a flashed): the first post-flash
    boot since the 20 Hz firmware that needed no power cycle, verdict "i2c boot
    clean" riding every RATE line. One data point, stated as such — the question
    closes as verdicts accumulate across flashes; the power-cycle ritual stays
    the fallback. Mag axes re-proven on the changed 0xA8 transaction: three
    distinct axes, |B| ~40.8 uT, matching pre-swap. imu6/mag health live on the
    RATE line.
2026-08-25 docs: field checklist updated for F2 — deltas section, beacon-aware close, time-based baseline wording
    docs/field-checklist.md stays the ONE canonical launch-day procedure; F2's
    field-visible changes land as §7b (10 Hz flight window then 1 Hz landed
    beacon — the flight now stays open until the sled powers off at recovery;
    frame shapes switching with St; the on-rail power-cycle doubling as I2C
    wedge recovery; the ground-radio wedge's manual restart; the
    RSSI-vs-distance recording ask — F2 IS the field-range measurement; the
    loss-statistic caveat). Two stale restatements corrected in place: the AGL
    baseline window is TIME-based (15 s), not "15 packets" — the old text
    restated the supe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
2026-08-25 feat(flights): archive export carries the 10 Hz build's tags
    The export column list was frozen at the 11 base tags, so F2's CSV would
    have silently dropped Vel/Gmx/Gmn/Wmx and the raw 9-DoF pad channels — the
    very data the 10 Hz build exists to produce, discovered in the pre-F2
    publish review. Columns extended in wire order (ADR 0005 A1.4). Red first
    (4 tests: flight tags, pad raw channels with Wmx honestly empty, pre-10 Hz
    records re-exporting with empty superset columns, column order pinned).
    Pre-existing flights stay re-derivable: a re-exported F1 differs from its
    published CSV only by empty additive columns, deterministically. 15/15
    export+cli; full ground suite unchanged (18 known env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
2026-08-25 feat(flights): publish subcommand — the Stage-1 data hop, mechanized
    Option (a) from the F2 publish review, approved 2026-08-25. Pure core
    (publish.py): derive the FULL index and write flights.json + the flight's
    CSV into the site repo's data dir — flights.json byte-identical to what
    rebuild writes, pinned by test, so publish can never become a second index
    writer. CLI glue: fetch session+ops from the Pi into ~/apogee-data-mirror
    (which doubles as the off-SD backup of the ops journal — the system's only
    irreplaceable file), --local-session for offline/testing. It STOPS at the
    site-repo diff: committing/pushing stays human, per the working agreement.
    Red first (import error, 5 tests); 5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
2026-08-25 fix(flights): arrival order is the authority — timestamp inversions no longer manufacture loss
    Found on the first 10 Hz field data (2026-08-25, Katana Jr flights): the
    session file's append order is the physical arrival order, but received_at
    wall stamps inverted by ~33 ms on a ~20 s cadence at the range. derive's
    time-sort reordered those packets, and each backwards SEQ pair became
    (-n % 65536) ~= 65,535 "lost" in the segmenter's gap stat — flight F1
    reported 720,906 lost from 11 inversions against a true 10. At 1 Hz an
    inversion could never cross packet boundaries; 10 Hz exposed it. The live
    path (linkstats) is immune — it consumes true arrival order.
    Two independent defenses, both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
2026-08-25 fix(flights): the site index is the ARCHIVE — publish unions across sessions
    Caught before the first multi-session publish ran: publish overwrote
    flights.json with only the current session's derivation, which would have
    erased July's F1 from the public page the moment the Katana Jr flights
    published. Union semantics, red-first: this derivation's flights upsert by
    flight_id, entries from other sessions survive, order is t_start; a fresh
    dir degenerates to exactly flights_to_json (the rebuild byte-identity pin
    still holds); a corrupt existing index refuses LOUDLY rather than clobber
    the archive. One test fixture corrected along the way (its "old" entry
    collided with the derived IDs — the c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
2026-08-25 fix(flights): publish emits the page's schema — flat, enriched, deterministic
    THE PAGE IS THE CONTRACT: projects/lora-flights.qmd reads flat entries with
    derived date / peak_agl_ft / loss_pct / csv — the shape the F1-era one-off
    publish produced by hand and nothing owned since. Caught at the staged diff:
    the new entries were nested-Flight shape and every chart and value box on
    the page would have shown NaN for the Katana Jr flights. publish now owns
    the flattening (_site_entry), derived deterministically from rebuild's
    Flights; the byte-identity-with-rebuild pin is REPLACED by a page-schema
    pin (every key the qmd reads, the derivations, and no nested stats), plus
    an annotations-ride-the-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
2026-08-25 docs: flight day 2026-08-25 — F2/F3 flown, captured, published; post-mortem recorded
    Two Katana Jr flights on the record with the numbers, the ~16 dB measured
    field margin at ~860 ft (replacing ADR 0005 §2's design assumption with
    flight data), the three same-evening bug finds cited by commit, and the
    open post-mortem items: hard power-cut at 95% battery (no service_stop),
    wake-on-charge no-fire, and the ~20 s received_at inversion cadence with
    the record-mono fix candidate. Zero flight data lost to any of them.
2026-08-30 feat(handheld): pure view-model for the 8.2 receiver — TDD slice 1
    LIFTOFF banner on the OBSERVED St 0->1 transition only (a handheld switched
    on mid-flight fabricates no liftoff), peak from observed ALT with the sled's
    own Max authoritative above it (RF loss hides peaks from a receive-only
    listener), apogee reveal latched on St:2, stale-not-blank after 5 s quiet,
    foreign-SYS dropped-but-counted mirroring ground/ingest/core.py's allowlist
    default. Tests drive the REAL ground/decode/v1.py decoder; time injected;
    zero I/O — the render/RX threads will consume snapshot(), the ground OLED's
    view-model seam.
    Claude-Session: https://claude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
2026-08-30 feat(handheld): pure OLED layout renderer — TDD slice 2
    View -> deterministic 128x32 1-bit PIL image; behavioral tests, no goldens
    (deferred, matching the ground OLED redesign posture). Idle page is visibly
    alive per the 2026-07-30 quiet-pad lesson; LIFTOFF! is a full-inverted
    banner tested to out-light the live page 2x; stale shows data age instead
    of feigned freshness; apogee reveal promotes peak to hero.
    Claude-Session: https://claude.ai/code/session_015fAkAFZ1nshPXDoLv5Q924
    [render.py, test_render.py]
2026-08-31 feat(handheld): RX glue — LoRaConfig-derived radio settings, payload path — TDD slice 3
    rfm9x_settings()/apply_settings() convert the ONE RF authority
    (ground/rx/sx127x.py::LoRaConfig, per ADR 0005 §7) into adafruit_rfm9x's
    property vocabulary — tested with a non-default config so the conversions
    can fail, plus a flight-defaults test that restates ADR 0005's numbers as
    independent cross-end evidence. handle_payload() feeds RH-stripped bytes
    through the real decoder into the model, never raises, counts accepted vs
    decode-errors; foreign-SYS stays the model's rejected-not-error counter.
    observe() now reports acceptance (additive).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
    [rx.py, test_rx.py, viewmodel.py]
2026-08-31 feat(handheld): loop layer + entry point — TDD slice 4
    rx_step/render_tick survive their own fault domain by COUNTING failures
    (display fault cannot stop capture; radio fault cannot kill the heartbeat
    — the two-surfaces lesson). HeartbeatDisplay ships the recovery preamble
    on EVERY frame (a reset SSD1306 still ACKs; nothing to trigger on) and a
    test PINS 0xAE out of the preamble — the ground box's once-a-second flash
    defect, encoded as a failing-capable check. Periodic redraw tested: quiet
    pad never looks dead. main.py is deliberately thin untested glue: Blinka
    construction (CE1/D25 per radio_check.py, OLED 0x3C), render thread at
    1 Hz on the snapshot() seam, SIGTERM-clean stop with a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
    [loop.py, main.py, oled.py, test_loop.py]
2026-08-31 feat(handheld): AGL pad baseline — the shared zero, frozen at liftoff — TDD slice 5
    Reuses ground/flights/baseline.py (pad_baseline + trim_history) — the same
    pure function the ground live path locks at flight_open — so the handheld
    displays AGL, not raw baro (first bench read -85 ft on the pad). Rolling
    verdict while St:0 with None honored (a pad that stops being quiet stops
    being a zero; the one-sample window would otherwise latch a false zero,
    caught in RED), frozen at the observed liftoff, raw fallback for mid-flight
    power-on. Max is ignored on the pad — 0 until the first in-flight sample
    by contract (firmware/src/main.cpp:402) — and baseline-corrected in flight.
    Co-Authored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
    [test_baseline.py, viewmodel.py]
2026-08-31 docs: Epic 8 session 2026-08-31 — 8.2 in service; ADR 0002; ops facts get one home
    RESUME handoff cites the five slice commits and the on-air evidence line;
    handheld/README 'Access & operations' becomes the single authority for the
    device's operational facts (WideRoad move, guest-isolation trap, service,
    PiSugar state, staged USB gadget); ADR 0002 records the reuse-not-copy
    architecture with its rejected alternatives.
    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
2026-08-31 docs: Epic 8 follow-ups — boot test witnessed, gadget verified, PiSugar interface dead both ways
    The three same-day verifications move from OPEN to WITNESSED (boot test,
    slice-5 AGL on the running bonnet, USB gadget end-to-end with the BCM2710
    Boot diagnostic freebie). PiSugar: solder attempt fixed neither symptom —
    I2C absent AND no power supply, one suspect (pogo/pad contact); Pi 5 config
    ported and armed, unverifiable until the bus lives. Pi 5 web-UI auth gap
    recorded as a named fact; Frank holds on changing it.
    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
2026-08-31 feat(handheld): battery % on the idle page from the pisugar-server gauge — TDD slice 6
    Pure parse of the :8423 'get battery' reply (the 'I2C not connected' case
    included — this box lived there), battery_tick counts a dead server rather
    than raising, the model retains last-known charge across failed reads (a
    stale number beats a vanishing one on a slow-moving value), and the idle
    page displays the value — tested as displayed, not as a flag. main.py polls
    every ~30 s on the render thread; counters line gains battery_errors.
    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
    [battery.py, loop.py, main.py, render.py, test_battery.py, viewmodel.py]
2026-08-31 docs: PiSugar interface FIXED and verified live; slice 6 recorded
    Second solder pass verified on the running box: 0x57/0x68 on the bus,
    gauge 88%, RTC on wall time, PiSugar-alone power with a clean unattended
    boot. Ported config promoted armed -> LIVE; double-tap and wake-on-charge
    still await first observation on THIS box.
    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
2026-08-31 feat(handheld): guess-the-apogee — named roster, two rules, buttons — Epic 8.4+8.5
    The pad screen prompts each kid BY NAME (Bacon, HnyBsct, Dragon — the
    PLAYERS knob): #5 up / #6 down in STEP_FT increments, #12 locks and seats
    the next kid. Liftoff closes the betting window (a dialed-but-unlocked kid
    still banks — they played); the apogee screen names the winner beside the
    actual peak; ties go to the earlier kid in the roster. RULE knob picks the
    variant: closest (absolute distance, default) or no-over (Price-Is-Right —
    busting loses; everyone busts, the rocket wins). St back to 0 after a
    flight auto-resets the round AND the model's flight latches (reveal, peak,
    frozen baseline)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
    [game.py, loop.py, main.py, render.py, test_baseline.py, test_game.py, test_game_render.py, viewmodel.py]
2026-08-31 feat(handheld): game polish from first family bench — two-press confirm, dial owns the bottom row
    Field feedback 2026-08-31: (1) one-press lock was guaranteed kid-fumble —
    #12 now asks '<name> <guess> OK?' and only a second press banks; dialing
    during the OK? cancels back to adjusting; liftoff mid-confirm still banks.
    (2) 'PAD -44' collided with the dial on the bottom row — during entry the
    dial owns the whole row (the state word is redundant while betting is open)
    and RSSI moves to the top-right of the live page. 56 host tests.
    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
    [game.py, render.py, test_game.py, test_game_render.py]
2026-08-31 feat(handheld): startup game-select + labeled display — second family-bench round
    Field feedback 2026-08-31, round two: (1) startup now ASKS which game —
    'GAME? Closest'/'NoOver', #5/#6 toggle, #12 confirms; the RULE knob is the
    menu's preselection, next-flight reset returns to the pick, and a launch
    mid-menu skips the game rather than wedging it. (2) every number gets a
    label: ALT before the hero, RSSI as '-44dBm' right-aligned top, (3) bottom
    row lifted y22->y20 — kid names no longer clip off the panel edge.
    60 host tests.
    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
    [game.py, render.py, test_game.py, test_game_render.py]
2026-08-31 fix(handheld): armed state + start-over chord — the bounce-to-menu bug, third family-bench round
    The next-flight reset fired on 'St IS 0' instead of 'St RETURNED to 0
    after a flight', so pad frames yanked a fully-locked game back to the
    rules menu the moment the last kid confirmed — now the reset requires
    _seen_flight, pinned by a regression test from the exact bench case.
    While locked-in on the pad the screen acknowledges it (LOCKED x3 - fly!)
    and holds armed until liftoff. Holding #5+#6 together is the start-over
    chord: back to the game pick from any phase, rule kept as preselection,
    single-button edges suppressed while the chord is down. 63 host tests.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
    [game.py, main.py, render.py, test_game.py, test_game_render.py]
2026-08-31 docs: Epic 8 closed — family-tested through three UX rounds; RocketLab mode agreed
    RESUME handoff retitled BUILT/IN SERVICE/FAMILY-TESTED, the three bench
    rounds cited by commit, epic table row 8 flipped to effectively-done
    (remaining: 8.3 awaits the lander, field trial next launch, double-tap +
    wake-on-charge unobserved). RocketLab third game recorded with its decided
    constraints: sim as single authority, curated certified motor table, real
    liftoff preempts the quiz.
    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
2026-08-31 feat(handheld): RocketLab sim core — deterministic 1-DOF apogee, calibrated to the real bird
    Curated kid-tweakable tables (6 rockets, 6 motors with CERTIFIED impulse/
    avg thrust — the code string is display only, an A8 averages ~3 N). Sim:
    average thrust over certified burn time, linear propellant burn-off,
    quadratic drag, no-liftoff guard, runaway guard. Independent evidence in
    the tests: vacuum result bracketed by the closed-form energy bound, and a
    calibration test against the fleet's OWN measured flight — which CAUGHT an
    invented 120 g Katana mass; the corrected value was derived from the
    flight physics (Vel max vs impulse) and then confirmed by Frank's scale at
    ~432 g. Sim now pre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
    [rockets.py, rocketsim.py, test_rocketsim.py]
2026-08-31 feat(handheld): RocketLab UI — menu entry, pickers with the physics shown, sim reveal
    GAME? menu grows RocketLab (wrapping 3-way cycle). Dedicated offline
    screens (no ALT/dBm): rocket picker shows MASS + diameter under the name
    (Frank's ask — that's where the intuition starts), motor picker shows
    certified impulse/avg thrust, guess entry reuses the named two-press
    grammar under a 'Katana + F15' header, and the last lock reveals SIM SAYS
    <peak>ft with the winner immediately — no launch needed. A real St
    transition preempts the quiz from any lab phase (the flight owns the
    screen); pad frames never disturb a lab reveal; #5+#6 chord bails to the
    menu. 79 host tests.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
2026-08-31 docs: RocketLab built and deployed — sim calibration story recorded
    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
2026-08-31 fix(handheld): RocketLab field round — menu label + rocket screen layout
    Two from Frank's live test: (1) the GAME? label derived from game.rule
    while the menu logic cycled three entries, so RocketLab displayed as a
    stale NoOver and looked missing — label now comes from menu_label, with a
    regression test asserting all three positions render distinctly (the old
    test only toggled once: a coverage hole, not a green light). (2) the
    rocket name at y10 ran into the mass line — name now sits top-right in
    line with ROCKET?, and both lab data rows lift y22->y20 (the descender
    lesson). 83 host tests.
    Claude-Session: https://claude.ai/code/se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
    [render.py, test_rocketlab.py]
2026-09-05 docs(site): portfolio pages for RadioRocket V2 and the Apogee handheld
    Two Quarto project pages, production source for velezf.github.io, plus the
    images they reference: six V2 build photos downscaled to 1600 px, two listing
    cards, and 19 OLED screens rendered by the repo's own pure renderers
    (ground/oled and handheld/app/render.py driven through the real GuessGame).
    The V2 page covers the V1→V2 delta, the packet contract, the sled's
    sample-fast/transmit-slow firmware, an elementary link-budget section and the
    design choices it forced (ADXL375 envelopes, byte budget, the Teensy respin),
    the Pi 5 ground station, the session-log-to-web pipeline, and the 2026-08-25
    flight day. The handheld pa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
2026-09-05 docs(site): recast the portfolio pages to "we" and credit Claude Code
    First person singular stays only where Frank alone was present (V1 lessons,
    the range, the bench, soldering, weighing the rocket). Shared design, code,
    tests and analysis become "we". Adds an explicit note on both pages that the
    work was built with Claude Code and what the division of labour was, and a
    new lead item in "What we learned" on working with an AI collaborator.
    Claude-Session: https://claude.ai/code/session_01YVsqeEvEUtufXQWzjp5rs2
2026-09-07 docs(site): SCE to AUX — the switch, its current role, and a possible future
    Adds a short section to the V2 page: the steely-eyed missile man story and why
    the replica switch is on the panel, its current behaviour (it is the box's
    power switch; AUX is on), and a bulleted design for a possible future role as
    the wedged-radio recovery control, owned by the panel supervisor.
    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
2026-09-25 docs(claude): cite global CLAUDE.md files instead of restating shared rules
    Working agreement, cite-don't-restate, and the parallel-agent canonical rules
    now live in ~/.claude/CLAUDE.md, ~/code/CLAUDE.md, and the parallel-agents
    skill. This file keeps only what is specific to this repo: admission and
    budget rules, hook wiring status, and the open-item consequences.
2026-09-25 chore(hooks): wire verify-cwd as a PreToolUse hook and fix two dead paths
    Register .claude/hooks/verify-cwd.sh in .claude/settings.json (matcher Bash),
    extracting the command from the hook JSON with jq first: Claude Code sends
    JSON on stdin, so the script's anchored ^git regex never matched the raw
    input and the guard passed everything. Move the chained-verification-into-
    push guard ahead of the anchor early-exits so it also runs on anchored
    commands, where it previously never fired. Pipe-tested all four cases.
    Closes the 'COMMITTED BUT NOT WIRED' item in CLAUDE.md.
2026-09-25 docs(claude): record verify-cwd hook as wired
