velezf/lora-rocket-telemetry/RocketLoRaTelemetry/Feather9x_RX/Rx_BaseStation/Basestationrear.jpeg

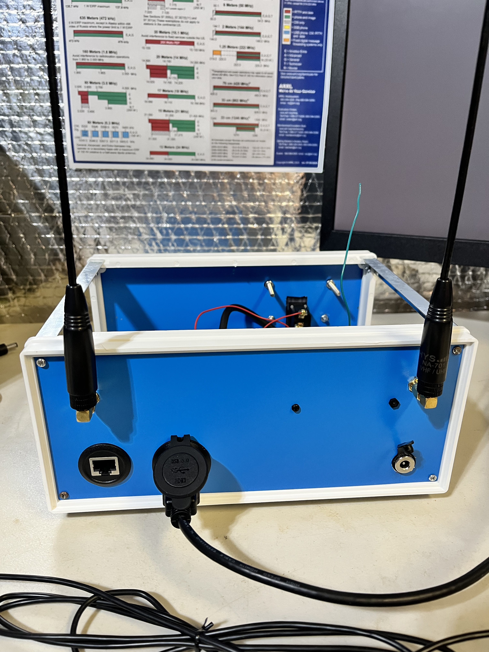
RocketLoRaTelemetry/Feather9x_RX/Rx_BaseStation/Basestationrear.jpeg
