velezf/lora-rocket-telemetry/RocketLoRaTelemetry/Feather9x_RX/Rx_BaseStation/Basestationtop.jpeg

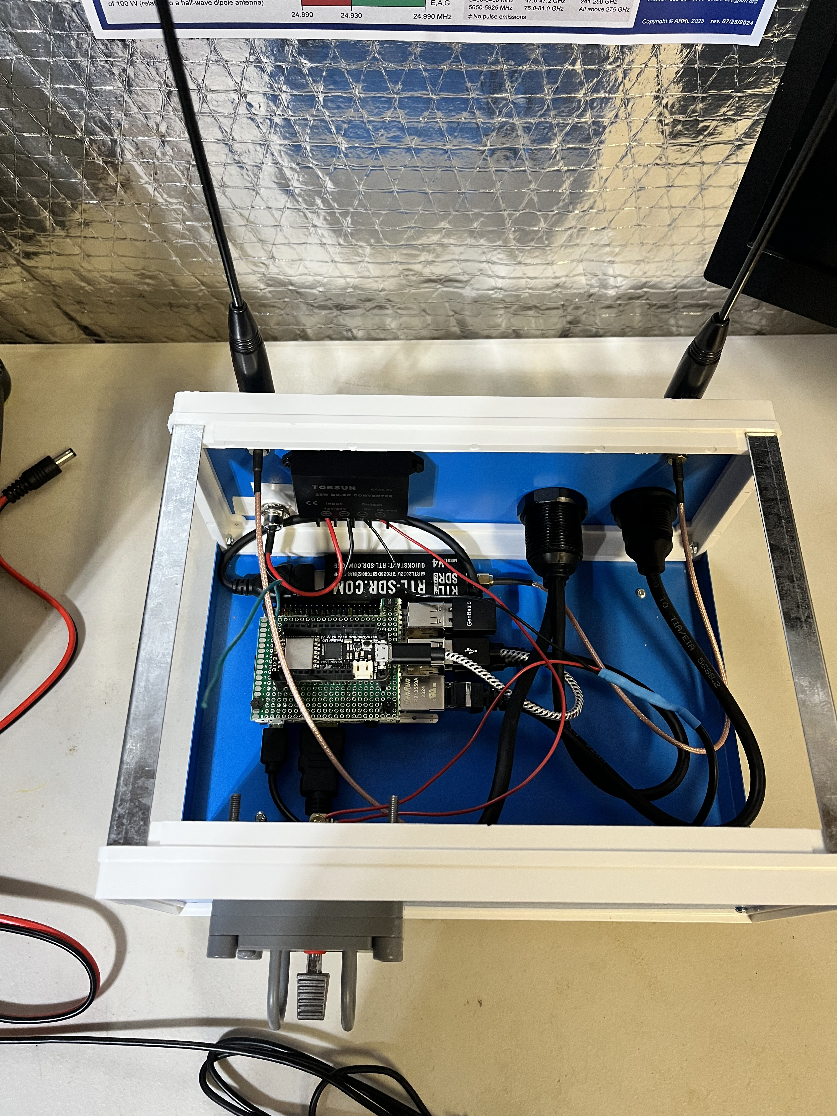
RocketLoRaTelemetry/Feather9x_RX/Rx_BaseStation/Basestationtop.jpeg
