velezf/lora-rocket-telemetry/RocketLoRaTelemetry/Feather9x_RX/Rx_BaseStation/Rocket copy.jpeg

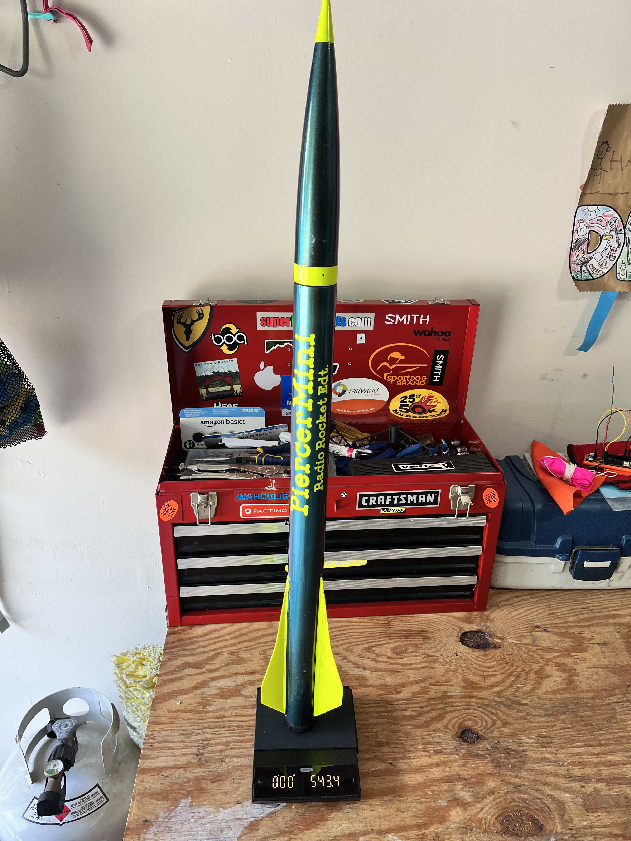
RocketLoRaTelemetry/Feather9x_RX/Rx_BaseStation/Rocket copy.jpeg
