velezf/lora-rocket-telemetry/RocketLoRaTelemetry/Feather9x_TX/Tx_Sled/Ebay.jpeg

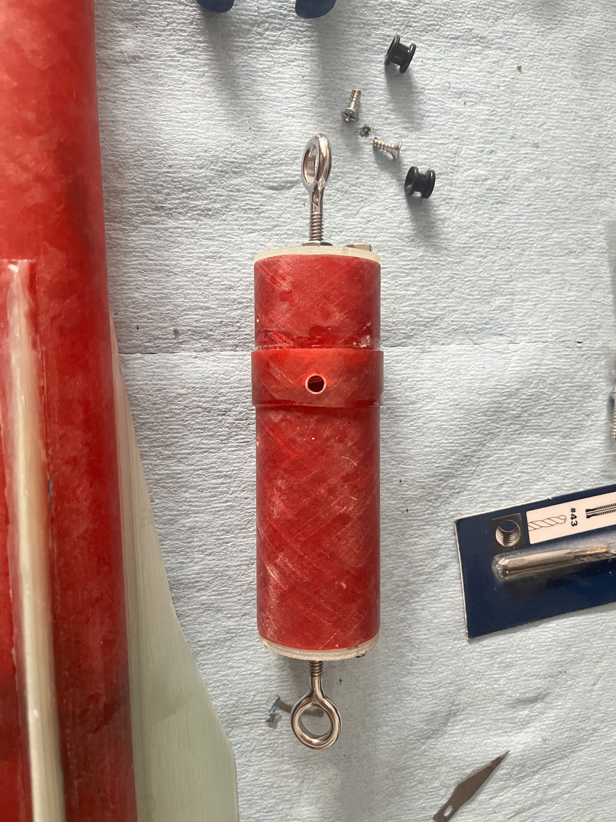
RocketLoRaTelemetry/Feather9x_TX/Tx_Sled/Ebay.jpeg
