velezf/lora-rocket-telemetry/RocketLoRaTelemetry/Feather9x_TX/Tx_Sled/Sled.jpeg

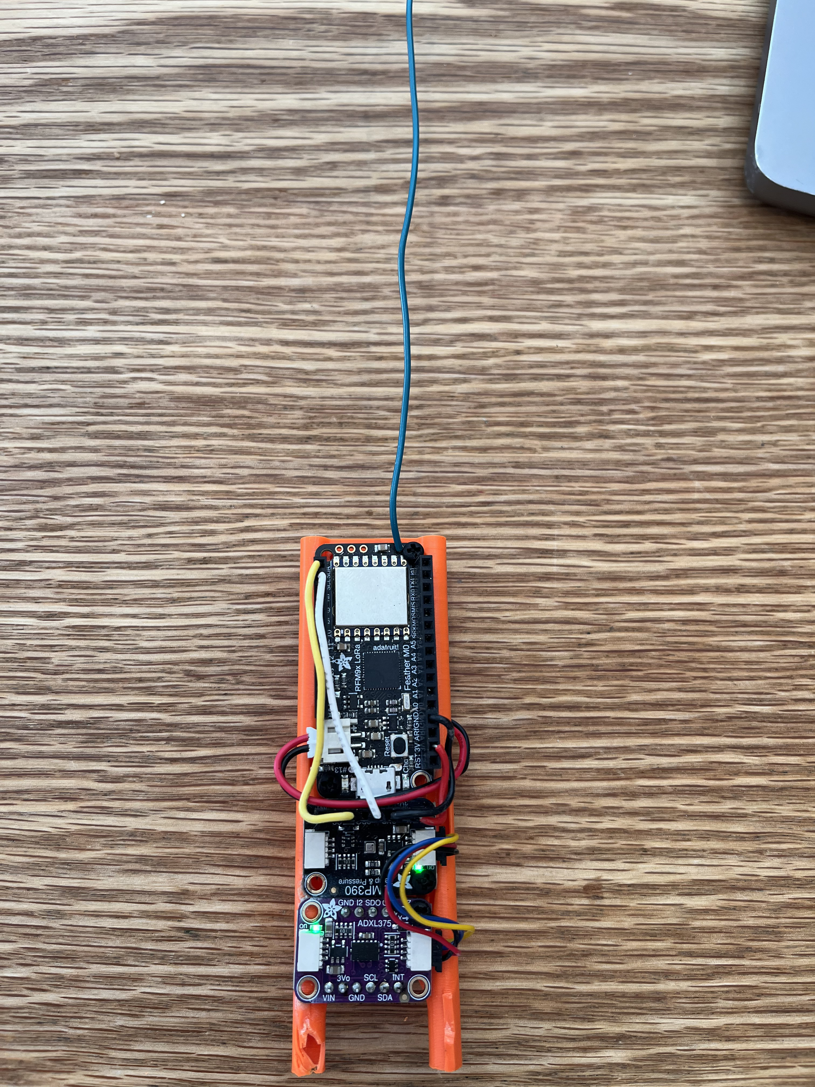
RocketLoRaTelemetry/Feather9x_TX/Tx_Sled/Sled.jpeg
